michaelwong382/pokemon-deckbox-stl/example/README.md

# Expected printout

Reference renders of the remix (grey = body, blue = lid, green = pin). Compare a print against these. Views 01 to 14 were made from the second round, without the buttons, and the box has looked the same from these angles since; view 15 shows the bottom from round 3 on. The later rounds have their own renders: [stl/remix/v3/example_images/](../stl/remix/v3/example_images/) for the bottom, [stl/remix/v4/example_images/](../stl/remix/v4/example_images/) for the box with its buttons in place, and [stl/remix/v5/example_images/](../stl/remix/v5/example_images/) for the current box with the recessed pin head and the test coupons, and [stl/100_deck_ver/example_images/](../stl/100_deck_ver/example_images/) for the 100-card version.

| File | Shows |
|---|---|
| 01_closed_front_iso.png | Closed box from the front left |
| 02_closed_back_iso.png | Closed box from the back: five hinge knuckles, pin head on the left end (standing proud here; flush from round 5) |
| 03_closed_front_elevation.png | Straight-on front view: the lid seam, thumb notch under the screen, D-pad left, buttons right |
| 04_closed_side_elevation.png | Straight-on side view: the sloping side seam and the hinge sticking out 7.5 mm at the back |
| 05_open_200deg.png | Lid swung fully back, showing the inside of the lid and the open body |
| 06_open_90deg.png | Lid half open |
| 07_lid_inside_thick_frame.png | Inside of the lid: the 4 mm frame around the window, chamfered side walls, hinge knuckles |
| 08_body_front_thumb_notch.png | Body from the front: thumb notch, flat top of the front wall, side tongue strips |
| 09_catch_bead_on_body.png | Catch bead on the raised inner layer of a side wall, lid part open |
| 10_catch_groove_in_lid.png | Cutaway of the lid's side wall from inside: the groove under the chamfered inner layer |
| 11_build_plate_layout.png | All three parts in print orientation on one plate |
| 12_lid_as_printed_face_down.png | Lid on the bed, front face down |
| 13_body_as_printed_upright.png | Body on the bed, upright |
| 14_pin_as_printed_on_flat_side.png | Pin on the bed, lying on a flat side, head at one end |
| 15_bottom_signature.png | Body from below, tipped back with the front edge at the top: "Yoojin" engraved across the bottom (engraving shaded darker; the round-5 engraving, 0.8 mm deep with the small loops filled) |
