michaelwong382/pokemon-deckbox-stl/stl/remix/README.md

# Remix versions

| Folder | Round | Status |
|---|---|---|
| [v1/](v1/) | Fit for sleeved cards, five-knuckle hinge, support-free printing | Superseded |
| [v2/](v2/) | v1 plus 4 mm screen frame, snap catches, thumb notch, lead-in chamfers | Superseded; print it if you want Ashwood's signature in the bottom |
| [v3/](v3/) | v2 with "Yoojin" engraved in the bottom instead of "Ashwood" | Superseded; same box with the designer's press-fit buttons |
| [v4/](v4/) | v3 plus a D-pad and buttons redrawn to push in by hand | Superseded; same box with the 1 mm engraving and the pin head standing proud of the hinge |
| [v5/](v5/) | v4 with a shallower engraving free of tiny islands, the pin head recessed into the hinge, and three fit-test coupons | Current, print this one |

Each folder has its own README with file list, print orientation and settings. The designer's unchanged files are in [../original/](../original/); rounds 1 to 3 use the designer's D-pad and buttons.
