michaelwong382/pokemon-deckbox-stl/stl/100_deck_ver/example_images/README.md

# Example images

Renders of the 100-card version in [../](../) (grey = body, blue = lid, green = pin, coral = D-pad and buttons, sand = a 67 × 69 × 92 mm block standing in for 100 double-sleeved cards). Compare a print against these. The cameras are those of the round-5 set in [../../remix/v5/example_images/](../../remix/v5/example_images/) where the view is the same.

| File | Shows |
|---|---|
| 01_closed_front_iso.png | Closed box from the front left, buttons in place: the same front as round 5 on a box as deep as it is wide |
| 02_closed_back_iso.png | Closed box from the back: five hinge knuckles, the pin head flush in the left knuckle |
| 03_closed_side_elevation.png | Straight-on side view: the side seam runs in one straight line from the front corner to the back wall, 14° instead of 25° |
| 04_open_200deg.png | Lid swung fully back |
| 05_open_90deg_with_100_cards.png | Lid half open with the 100-card block in the body: it stands clear of the walls and 1.5 mm below the lid's ceiling line |
| 06_build_plate_layout.png | All nine pieces of the box in print orientation on one plate: body, lid, pin, D-pad, two A/B, two Start/Select |
| 07_lid_as_printed_face_down.png | Lid on the bed, front face down, 87 mm tall |
| 08_body_as_printed_upright.png | Body on the bed, upright, 78 × 80 mm footprint |
| 09_bottom_straight_on.png | The bottom straight on, front edge at the top: "Yoojin" in the middle of the 74 × 76 mm floor, the hinge knuckles along the back |
| 10_closed_from_below.png | Closed box from below its front left corner: the engraving, the front and the buttons |
| 11_next_to_the_60_card_box.png | The 100-card box beside the round-5 box, fronts aligned |
| 12_catch_bead_on_body.png | Catch bead on the raised inner wall of a side wall, lid part open: the same bead as round 5, 17 mm behind the front face, on the gentler seam |
