michaelwong382/pokemon-deckbox-stl/stl/remix/v5/example_images/README.md

# Example images

Renders of the round-5 files in [../](../) (grey = body, blue = lid, green = pin, coral = D-pad and buttons). Compare a print against these. Views 01 to 20 use the same cameras as [../../v4/example_images/](../../v4/example_images/); views 21 to 23 show the recessed pin head and the test coupons. The engraving in the bottom is shaded darker so it stands out.

| File | Shows |
|---|---|
| 01_closed_front_iso.png | Closed box from the front left, buttons in place |
| 02_closed_back_iso.png | Closed box from the back: five hinge knuckles, the pin head flush in the left knuckle |
| 03_closed_front_elevation.png | Straight-on front view: the lid seam, thumb notch under the screen, D-pad left, A/B right, Start and Select below |
| 04_closed_side_elevation.png | Straight-on side view: the sloping side seam, the hinge sticking out 7.5 mm at the back, the buttons 1.5 mm proud of the front |
| 05_open_200deg.png | Lid swung fully back, showing the inside of the lid and the open body |
| 06_open_90deg.png | Lid half open |
| 07_lid_inside_thick_frame.png | Inside of the lid: the 4 mm frame around the window, chamfered side walls, hinge knuckles |
| 08_body_front_thumb_notch.png | Body from the front: thumb notch, flat top of the front wall, side tongue strips, buttons in place |
| 09_catch_bead_on_body.png | Catch bead on the raised inner layer of a side wall, lid part open |
| 10_catch_groove_in_lid.png | Cutaway of the lid's side wall from inside: the groove under the chamfered inner layer |
| 11_build_plate_layout.png | All nine pieces of the box in print orientation on one plate: body, lid, pin, D-pad, two A/B, two Start/Select |
| 12_lid_as_printed_face_down.png | Lid on the bed, front face down |
| 13_body_as_printed_upright.png | Body on the bed, upright |
| 14_pin_as_printed_on_flat_side.png | Pin on the bed, lying on its flat side, the round head at one end |
| 15_closed_from_below.png | Closed box from below its front left corner: "Yoojin" across the bottom, buttons on the front |
| 16_bottom_straight_on.png | The bottom straight on, front edge at the top: the whole engraving, with the hinge knuckles along the back |
| 17_engraving_close_up.png | Close-up of "Yoo" from a low angle, showing the 0.8 mm depth of the strokes and the filled loops at the tops of the o's |
| 18_buttons_exploded.png | The buttons pulled 9 mm out in front of their seats: the D-pad's cross pocket, the A/B pockets with their peg holes, the Start/Select pockets |
| 19_buttons_as_printed.png | The five button pieces on the bed: D-pad and A/B face down with the four-rib pegs up, Start/Select standing with a rib on each side |
| 20_buttons_in_place.png | Close-up of the front with the buttons seated |
| 21_pin_head_recessed.png | Close-up of the left end of the hinge: the pin's round head flush in its recess in the end knuckle |
| 22_test_coupons_as_printed.png | The three coupons on the bed in print orientation, with the pin and the buttons: the seats coupon standing on its foot, the body hinge strip on its foot, the lid hinge strip on its cut face |
| 23_test_coupons_in_use.png | The seats coupon with the buttons pushed in, and the two hinge strips on the pin with the lid strip half open |
