michaelwong382/pokemon-deckbox-stl/example/01_closed_front_iso.png

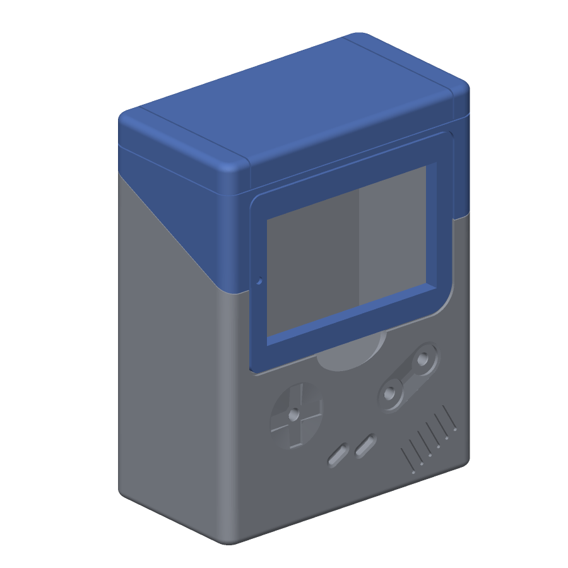
example/01_closed_front_iso.png
