michaelwong382/pokemon-deckbox-stl/example/06_open_90deg.png

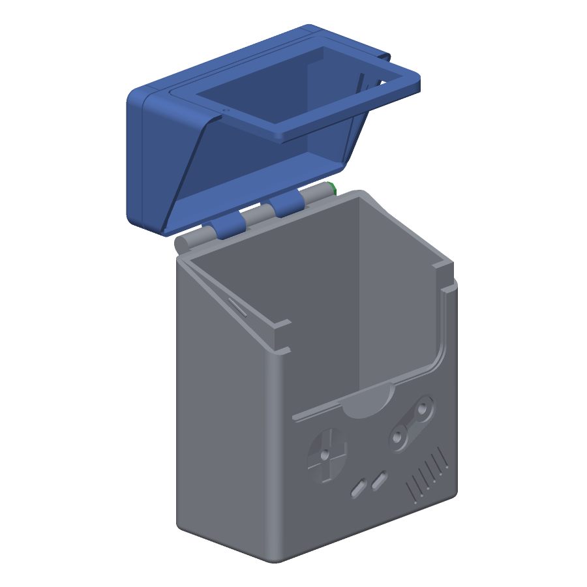
example/06_open_90deg.png
