michaelwong382/pokemon-deckbox-stl/example/07_lid_inside_thick_frame.png

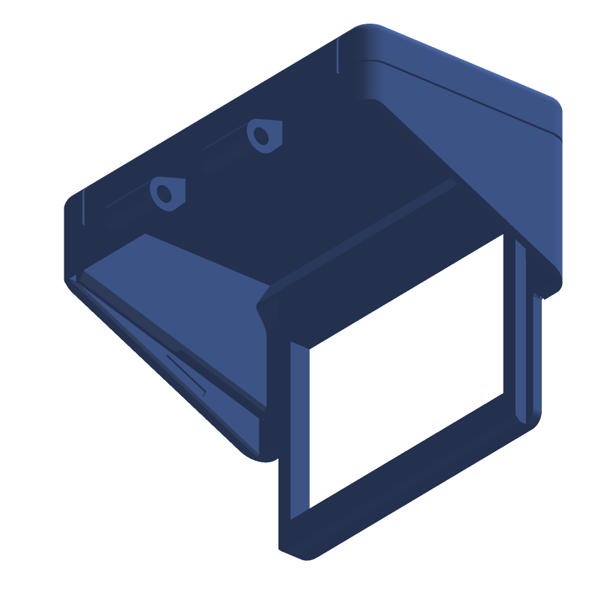
example/07_lid_inside_thick_frame.png
