michaelwong382/pokemon-deckbox-stl/example/08_body_front_thumb_notch.png

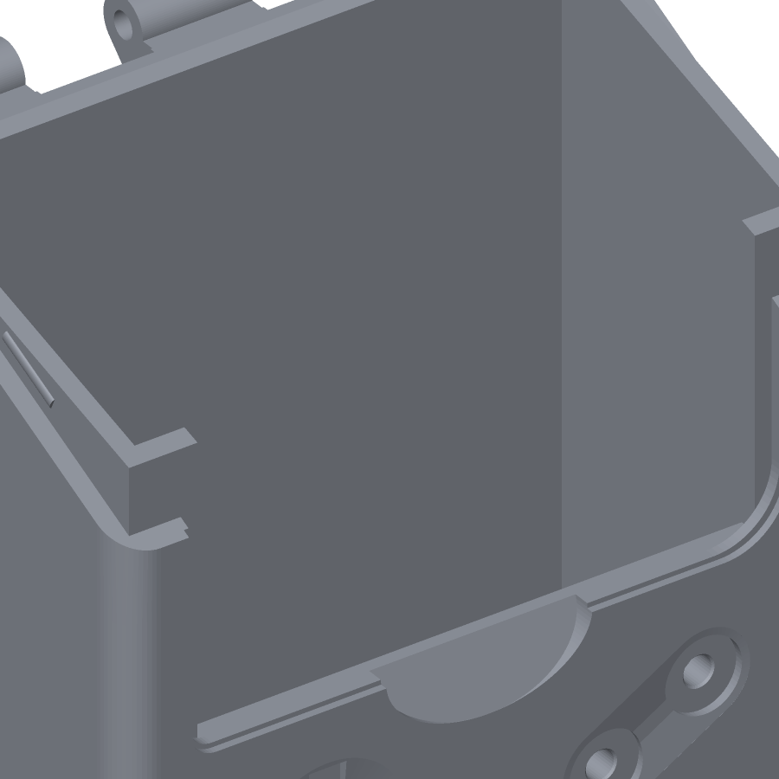
example/08_body_front_thumb_notch.png
