michaelwong382/pokemon-deckbox-stl/example/15_bottom_signature.png

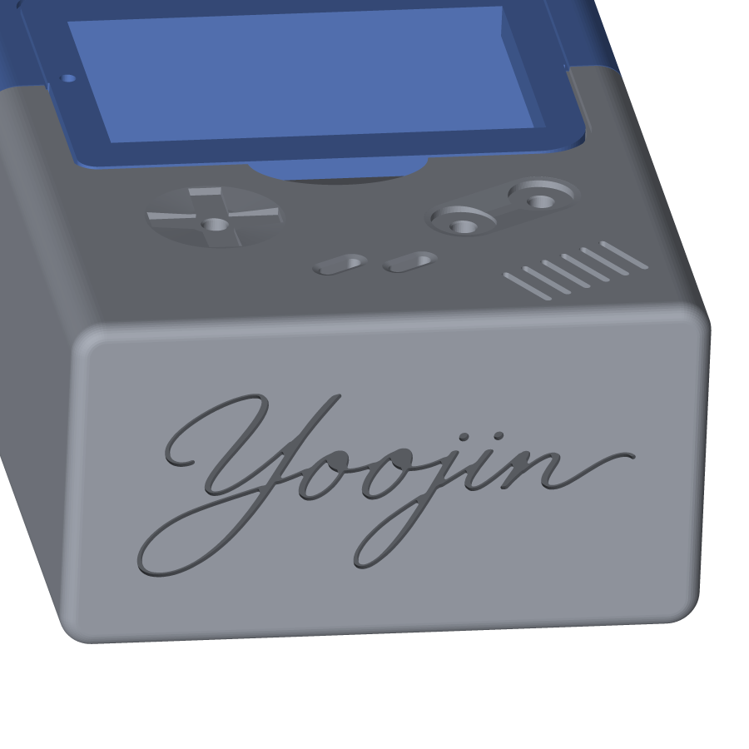
example/15_bottom_signature.png
