michaelwong382/pokemon-deckbox-stl/images/ChatGPT Image Oct 28, 2026, 07_20_07 PM.png

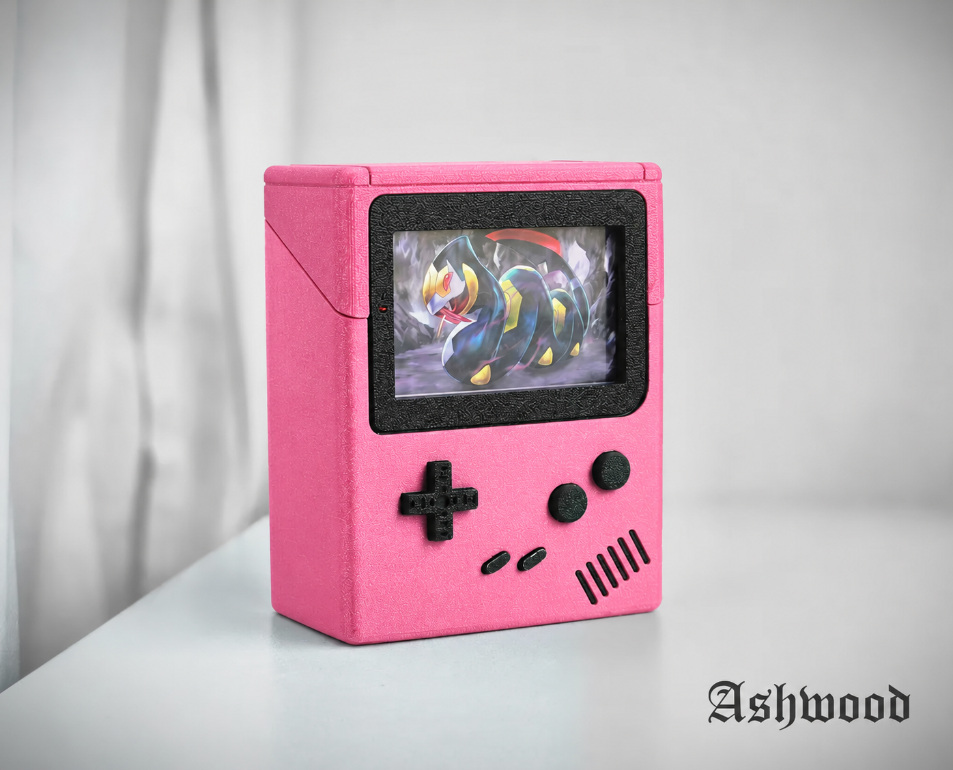
images/ChatGPT Image Oct 28, 2026, 07_20_07 PM.png
