michaelwong382/pokemon-deckbox-stl/images/Elegant_Yoojin_Calligraphy.png

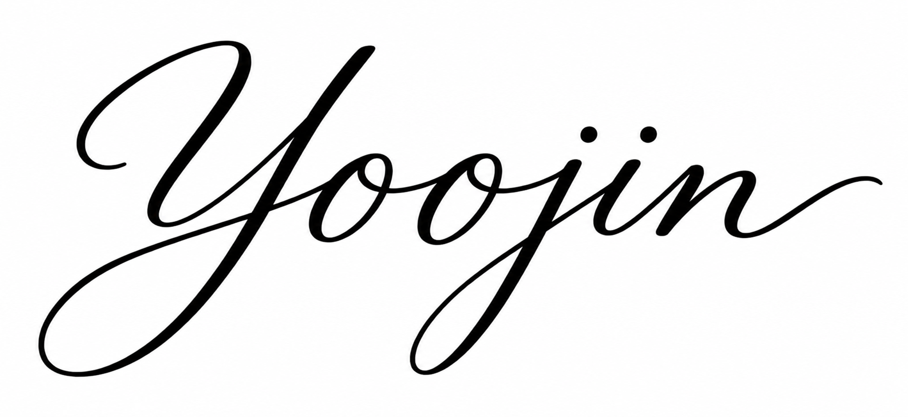
images/Elegant_Yoojin_Calligraphy.png
