michaelwong382/pokemon-deckbox-stl/images/pickachu/1-1.webp

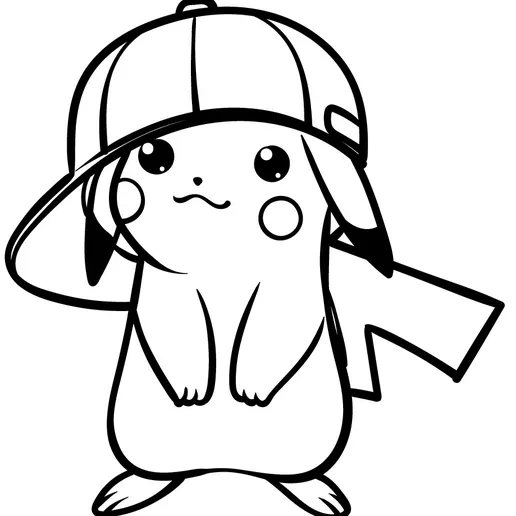
images/pickachu/1-1.webp
