michaelwong382/pokemon-deckbox-stl/images/pickachu/11_pickachu_berries_outline.png

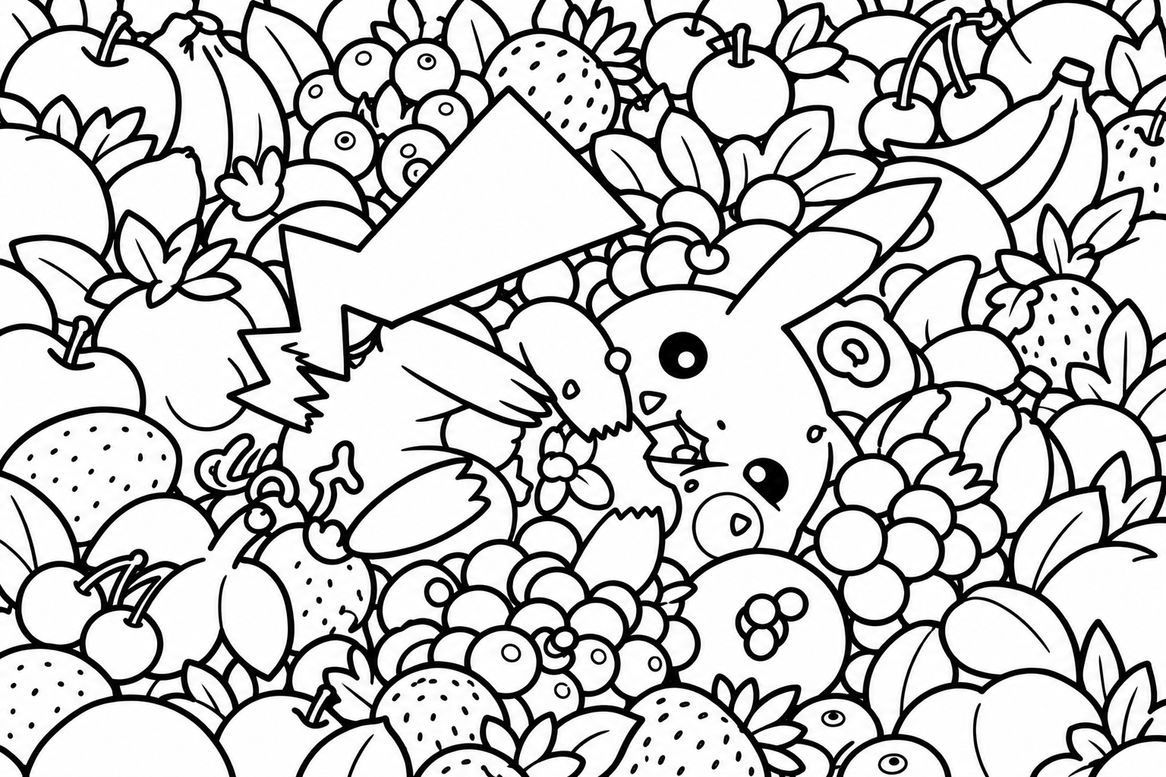
images/pickachu/11_pickachu_berries_outline.png
