michaelwong382/pokemon-deckbox-stl/images/pickachu/il_1588xN.7435648637_o518.webp

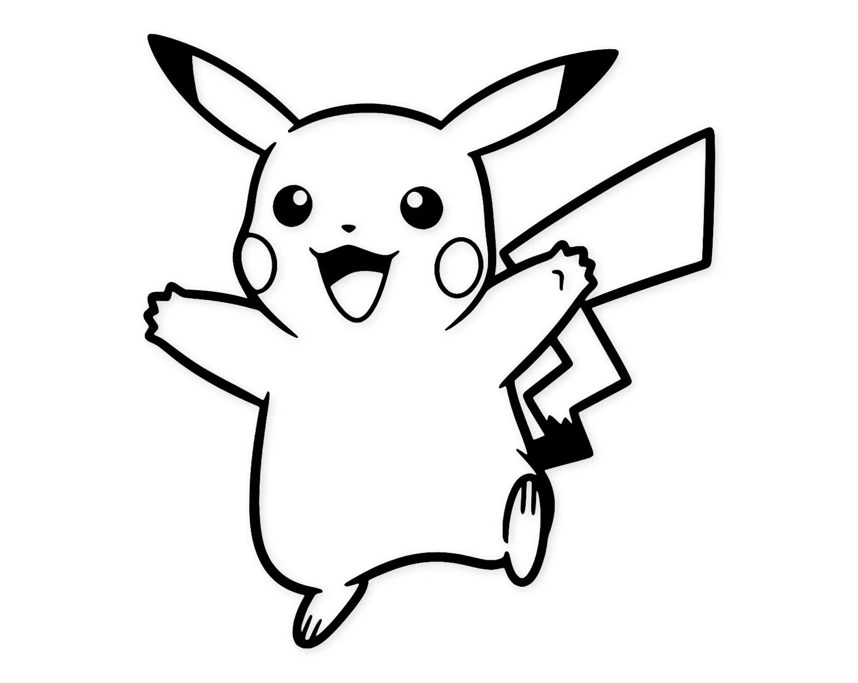
images/pickachu/il_1588xN.7435648637_o518.webp
