michaelwong382/pokemon-deckbox-stl/images/pickachu/il_1588xN.7897305927_3qdi.webp

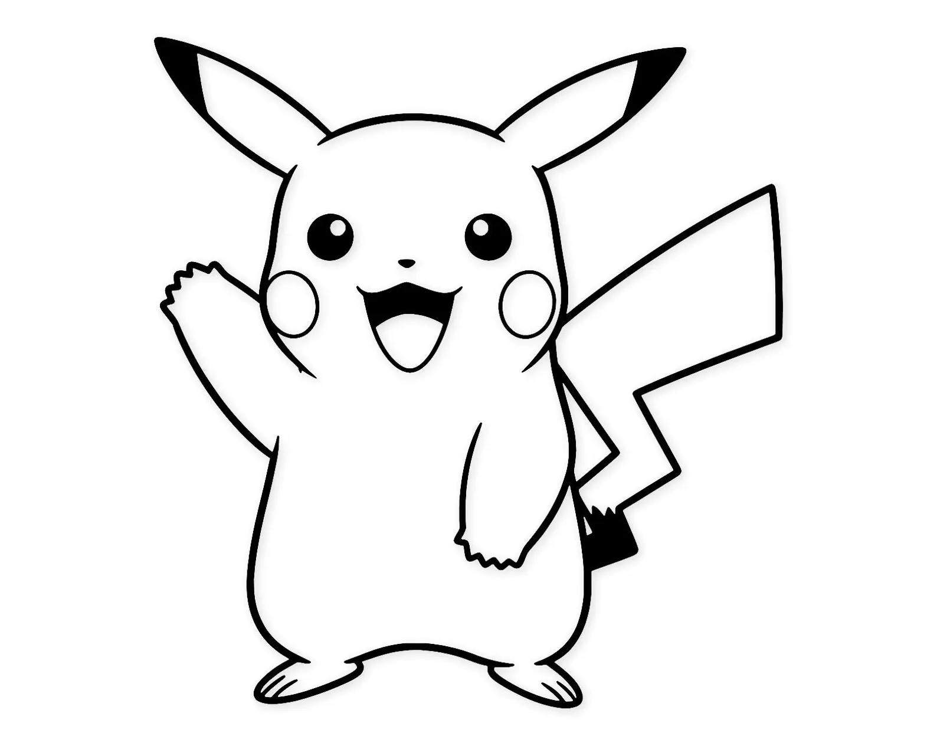
images/pickachu/il_1588xN.7897305927_3qdi.webp
