michaelwong382/pokemon-deckbox-stl/images/pickachu/il_1588xN.8249798320_c1d0.webp

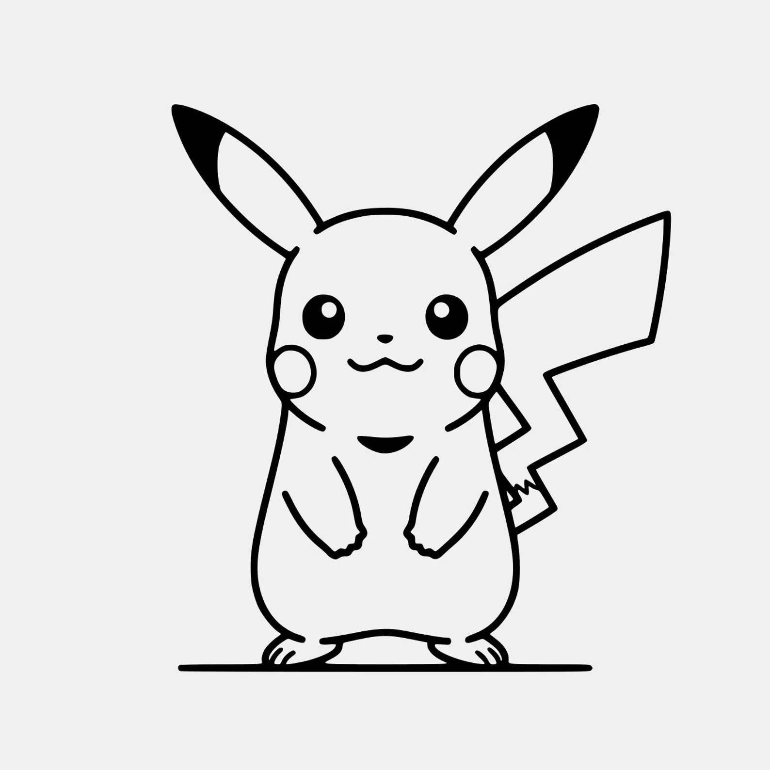
images/pickachu/il_1588xN.8249798320_c1d0.webp
