michaelwong382/pokemon-deckbox-stl/images/pickachu/il_1588xN.8268143871_6cok.webp

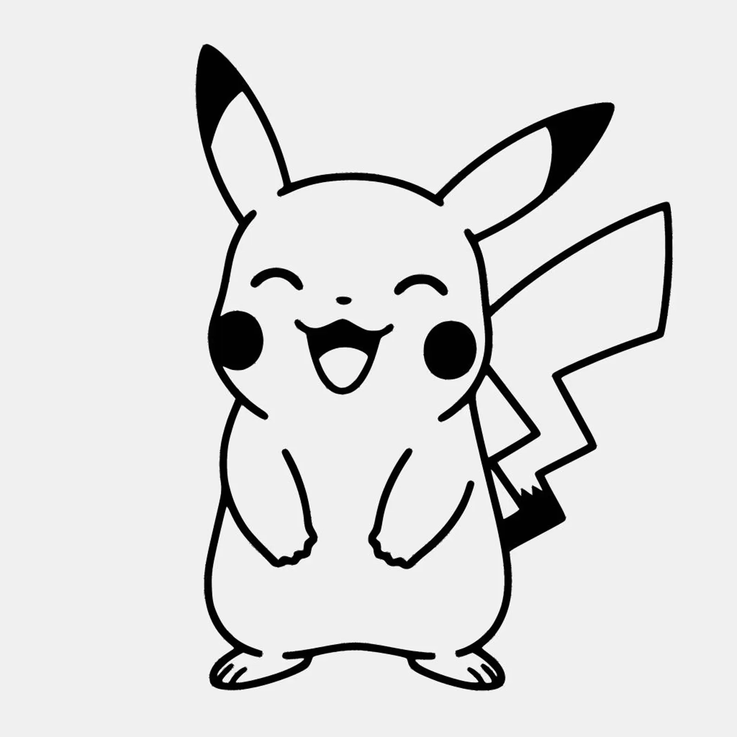
images/pickachu/il_1588xN.8268143871_6cok.webp
