michaelwong382/pokemon-deckbox-stl/images/pickachu/Pikachu-I-01-scaled.jpg

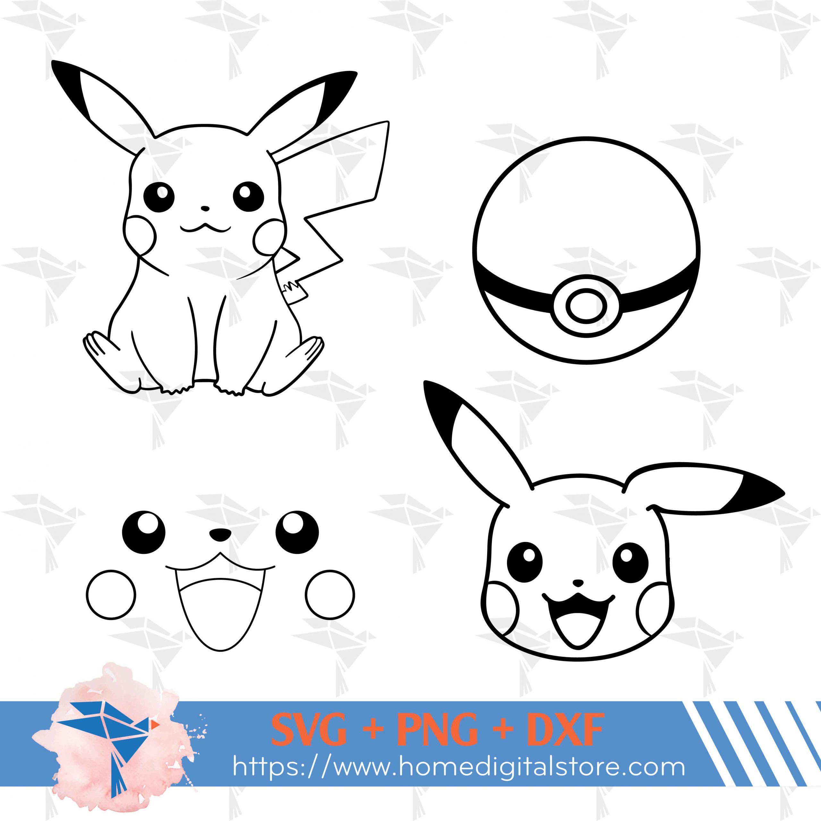
images/pickachu/Pikachu-I-01-scaled.jpg
