michaelwong382/pokemon-deckbox-stl/images/pickachu/s-l1600.jpg

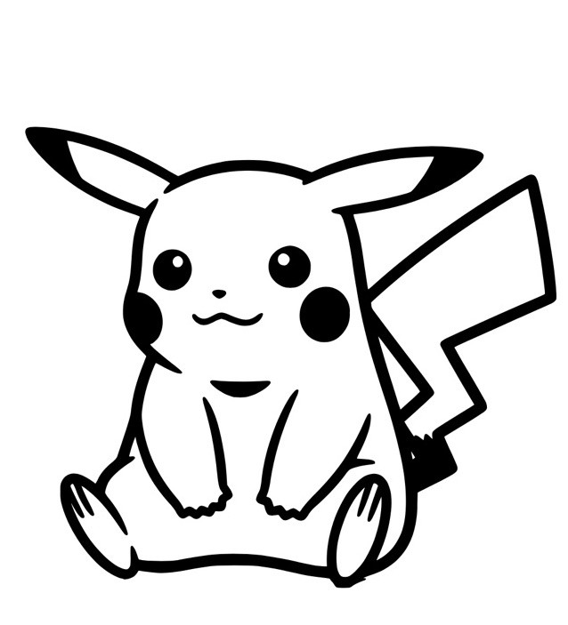
images/pickachu/s-l1600.jpg
