michaelwong382/pokemon-deckbox-stl/stl/100_deck_ver/example_images/01_closed_front_iso.png

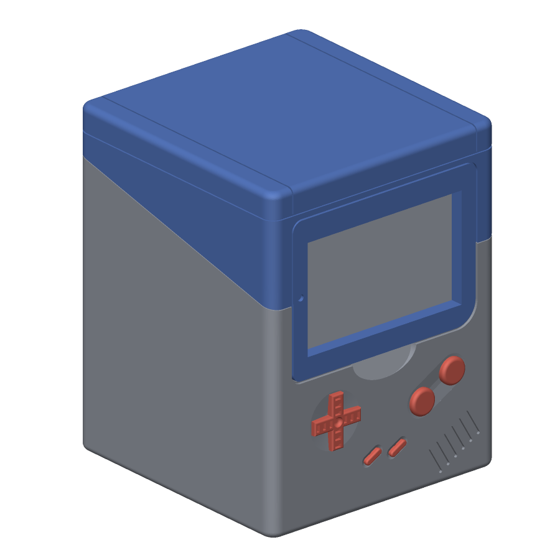
stl/100_deck_ver/example_images/01_closed_front_iso.png
