michaelwong382/pokemon-deckbox-stl/stl/100_deck_ver/example_images/02_closed_back_iso.png

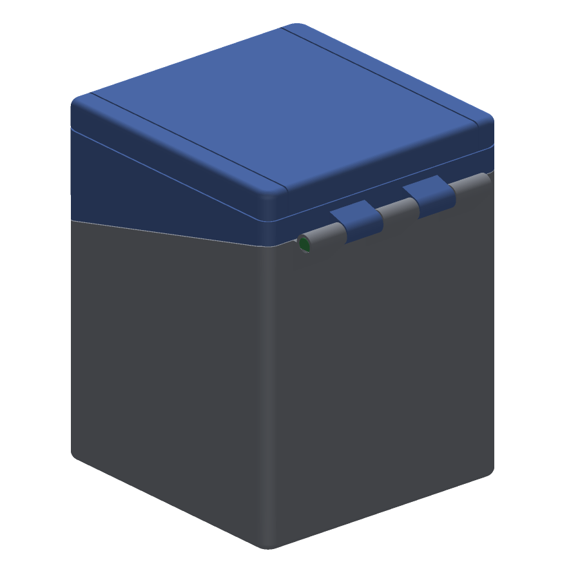
stl/100_deck_ver/example_images/02_closed_back_iso.png
