michaelwong382/pokemon-deckbox-stl/stl/100_deck_ver/example_images/03_closed_side_elevation.png

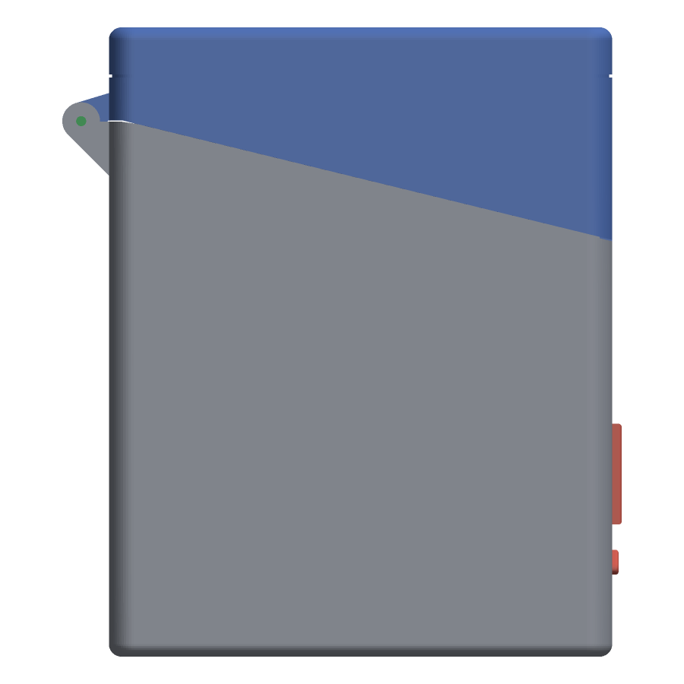
stl/100_deck_ver/example_images/03_closed_side_elevation.png
