michaelwong382/pokemon-deckbox-stl/stl/100_deck_ver/example_images/04_open_200deg.png

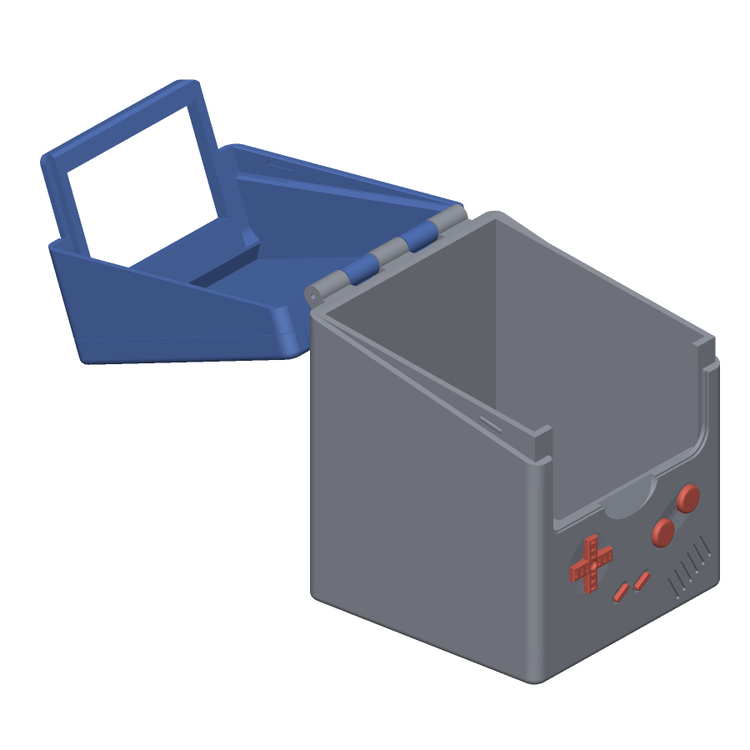
stl/100_deck_ver/example_images/04_open_200deg.png
