michaelwong382/pokemon-deckbox-stl/stl/100_deck_ver/example_images/05_open_90deg_with_100_cards.png

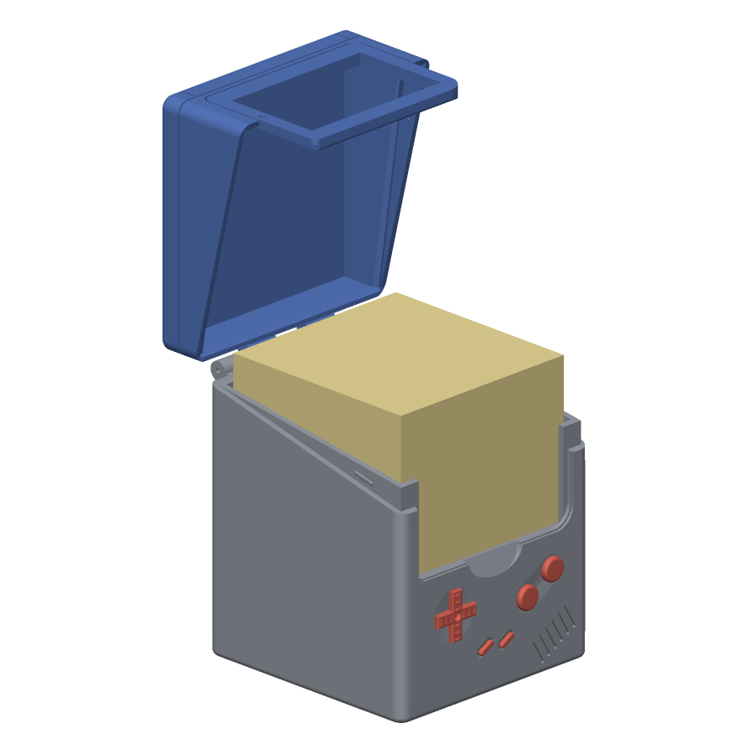
stl/100_deck_ver/example_images/05_open_90deg_with_100_cards.png
