michaelwong382/pokemon-deckbox-stl/stl/100_deck_ver/example_images/09_bottom_straight_on.png

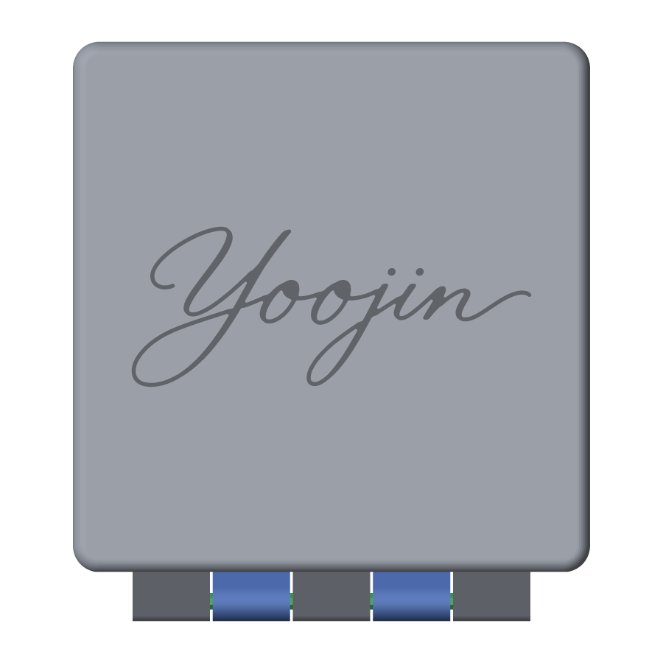
stl/100_deck_ver/example_images/09_bottom_straight_on.png
