michaelwong382/pokemon-deckbox-stl/stl/100_deck_ver/example_images/10_closed_from_below.png

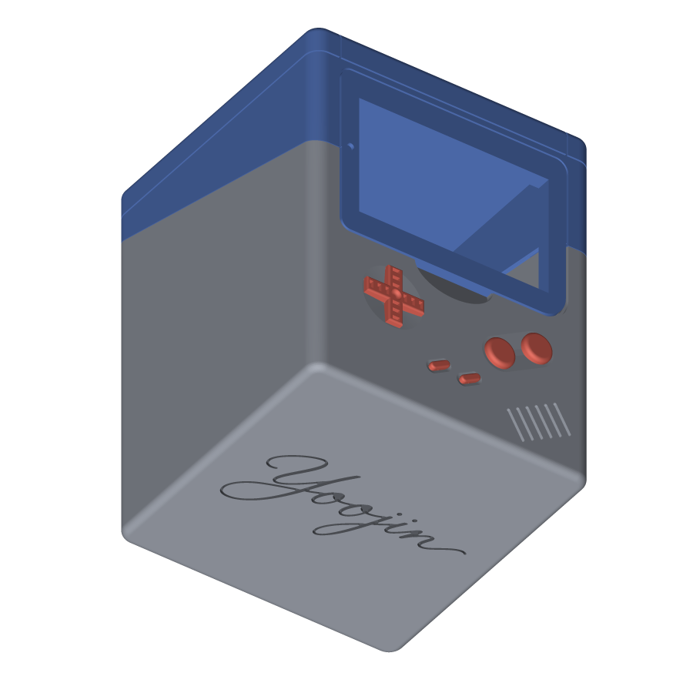
stl/100_deck_ver/example_images/10_closed_from_below.png
