michaelwong382/pokemon-deckbox-stl/stl/100_deck_ver/example_images/11_next_to_the_60_card_box.png

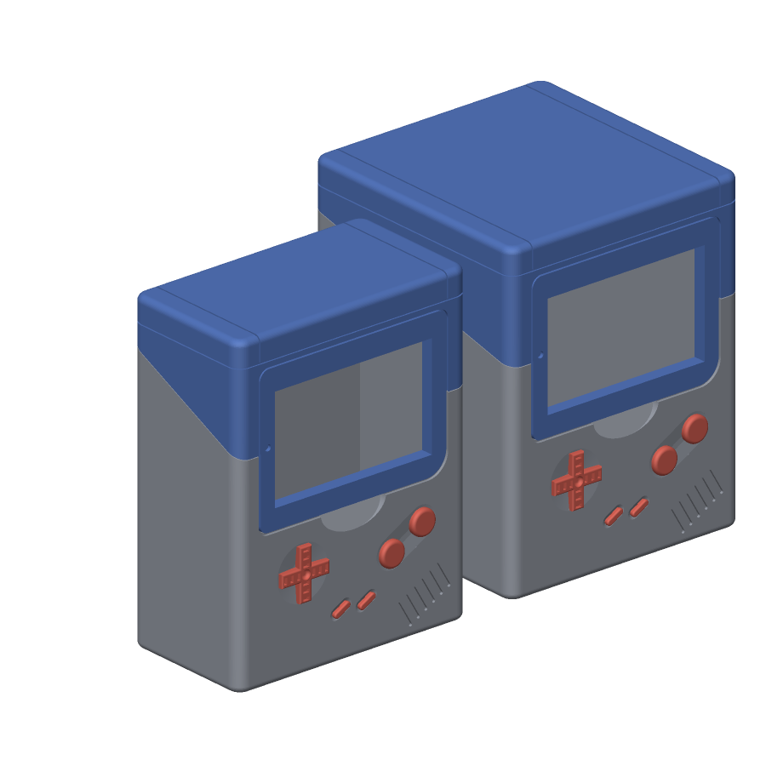
stl/100_deck_ver/example_images/11_next_to_the_60_card_box.png
