michaelwong382/pokemon-deckbox-stl/stl/100_deck_ver/example_images/12_catch_bead_on_body.png

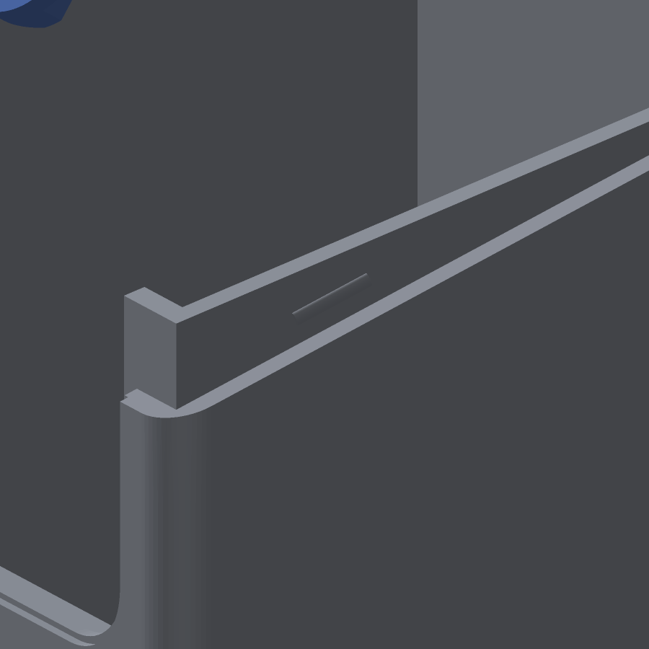
stl/100_deck_ver/example_images/12_catch_bead_on_body.png
