michaelwong382/pokemon-deckbox-stl/stl/pickachu/01_waving_back.png

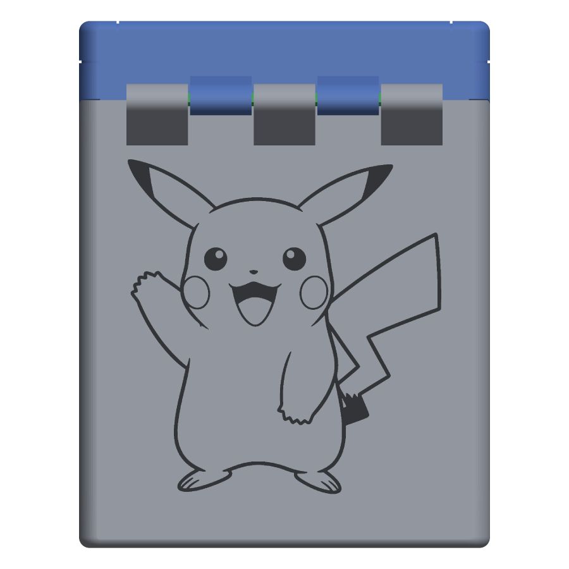
stl/pickachu/01_waving_back.png
