michaelwong382/pokemon-deckbox-stl/stl/pickachu/02_jumping_back.png

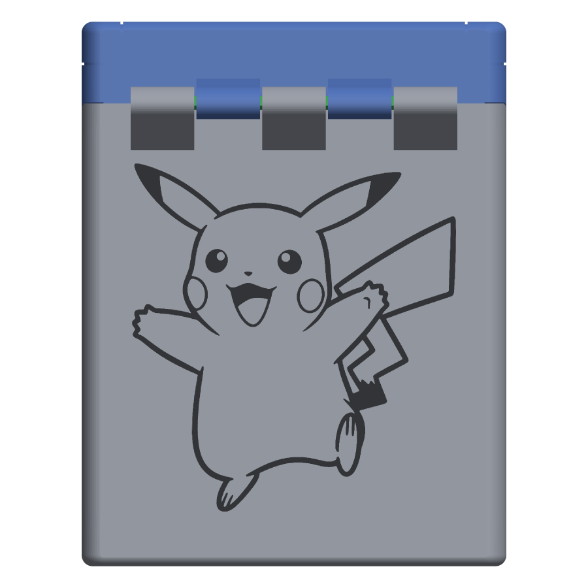
stl/pickachu/02_jumping_back.png
