michaelwong382/pokemon-deckbox-stl/stl/pickachu/04_standing_laughing_back.png

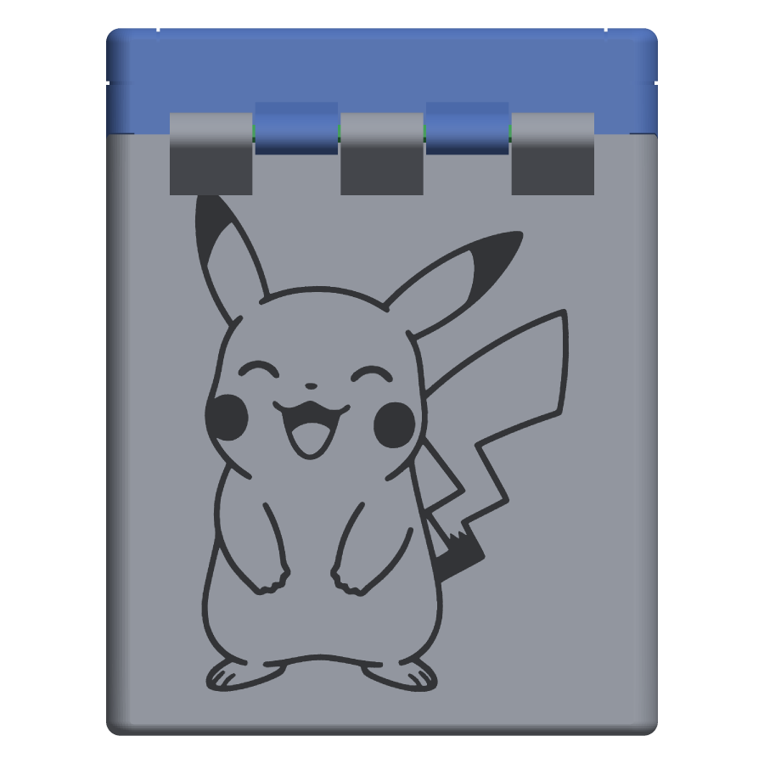
stl/pickachu/04_standing_laughing_back.png
