michaelwong382/pokemon-deckbox-stl/stl/pickachu/08_face_back_iso.png

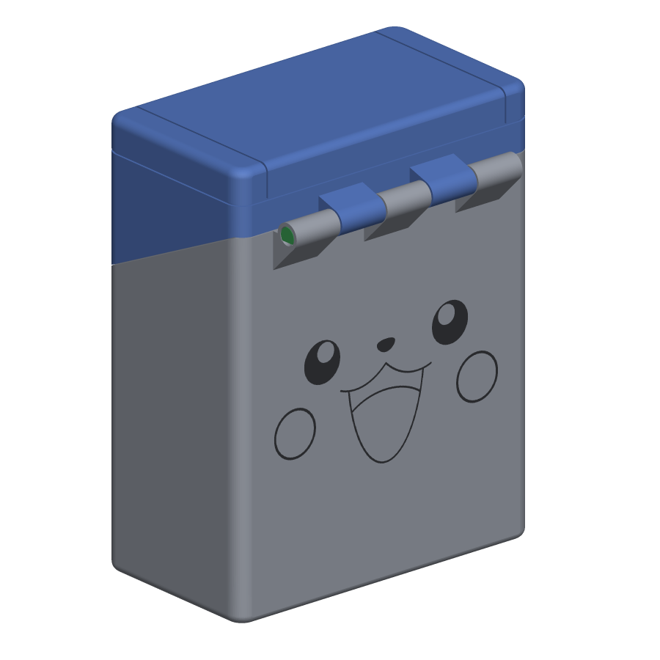
stl/pickachu/08_face_back_iso.png
