michaelwong382/pokemon-deckbox-stl/stl/pickachu/10_pokeball_back.png

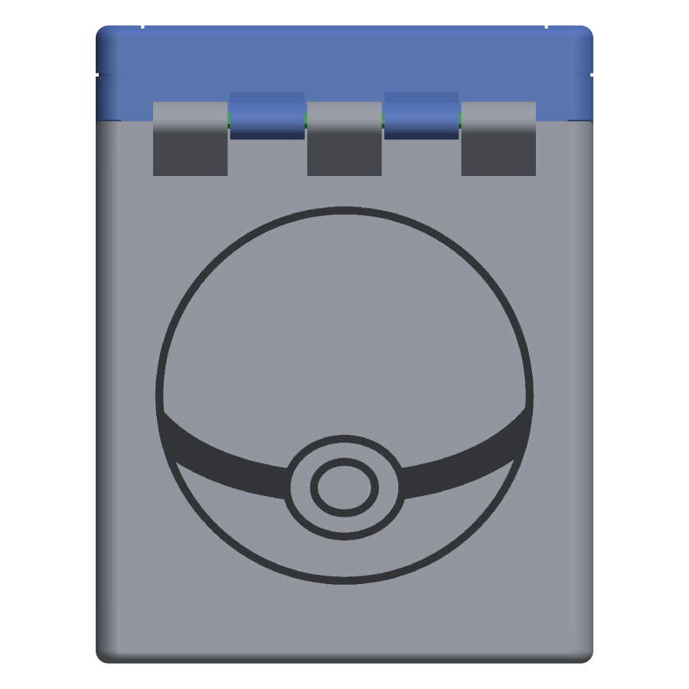
stl/pickachu/10_pokeball_back.png
