michaelwong382/pokemon-deckbox-stl/stl/pickachu/11_berries_back_iso.png

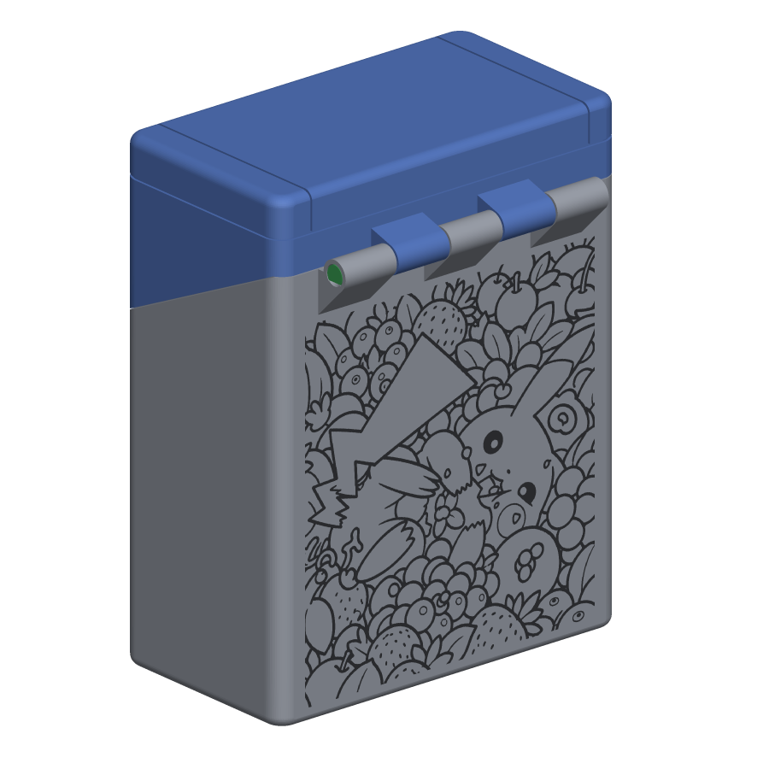
stl/pickachu/11_berries_back_iso.png
