michaelwong382/pokemon-deckbox-stl/stl/pickachu/v1_sitting_outline/example_images/04_engraving_raking_light.png

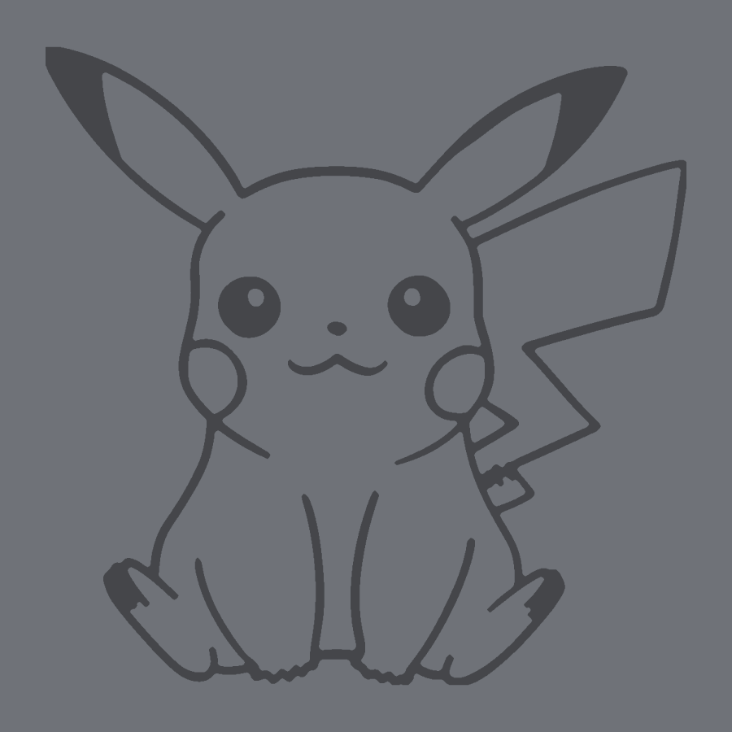
stl/pickachu/v1_sitting_outline/example_images/04_engraving_raking_light.png
