michaelwong382/pokemon-deckbox-stl/stl/pickachu/v2_berries/example_images/04_engraving_raking_light.png

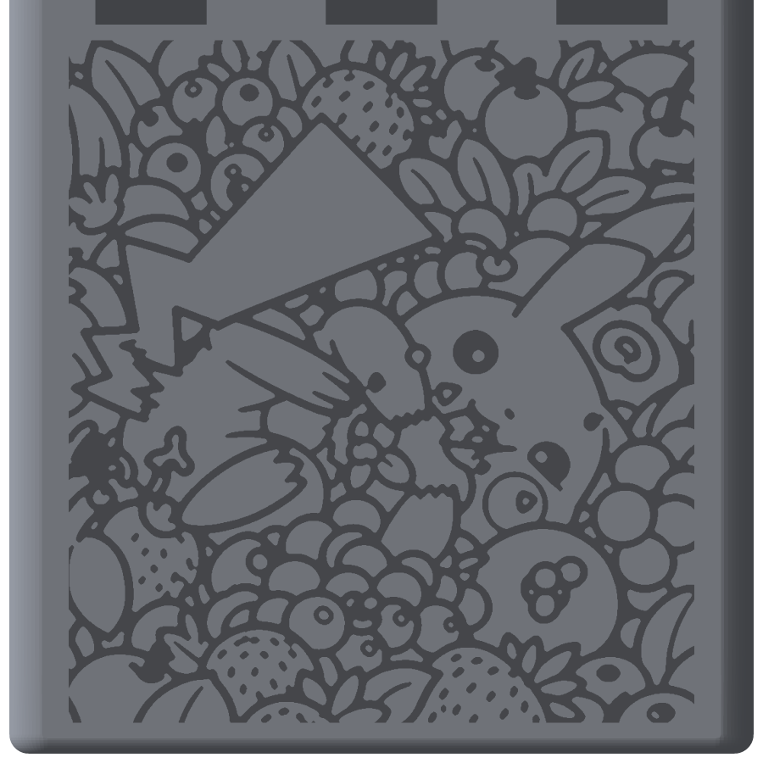
stl/pickachu/v2_berries/example_images/04_engraving_raking_light.png
