michaelwong382/pokemon-deckbox-stl/stl/pickachu/v3_berries_rotated/example_images/04_engraving_raking_light.png

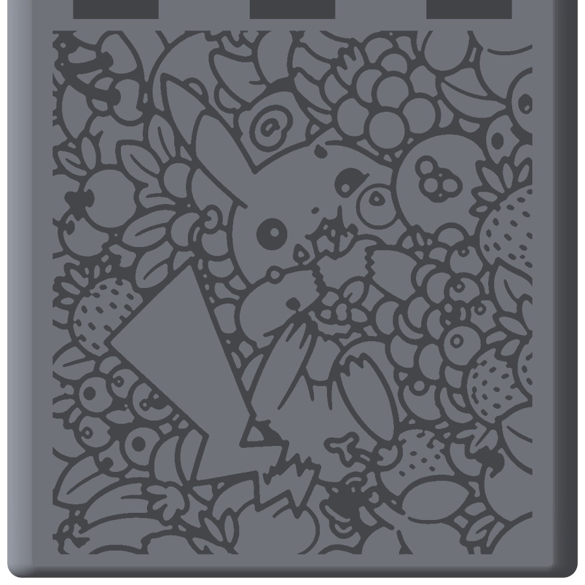
stl/pickachu/v3_berries_rotated/example_images/04_engraving_raking_light.png
