michaelwong382/pokemon-deckbox-stl/stl/pickachu/v4_berries_fade/example_images/03_engraving_close_up.png

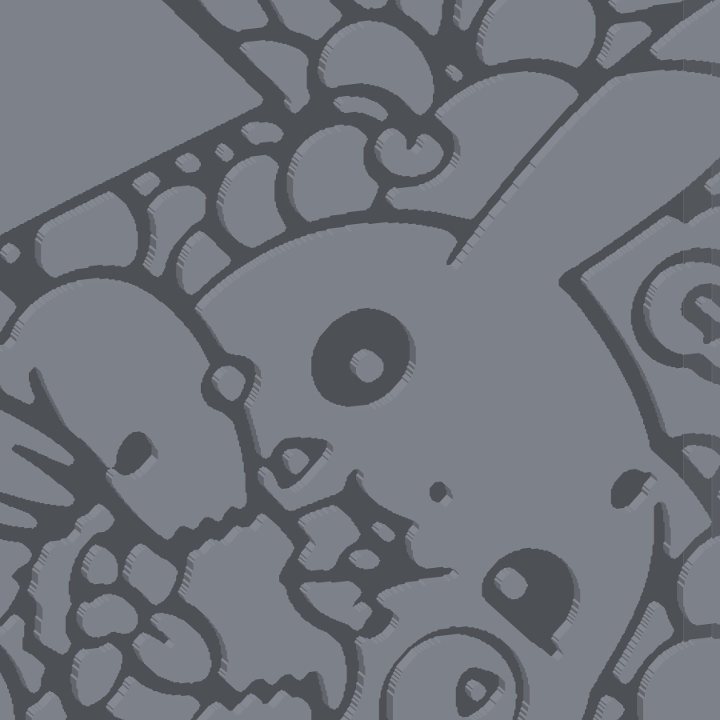
stl/pickachu/v4_berries_fade/example_images/03_engraving_close_up.png
