michaelwong382/pokemon-deckbox-stl/stl/pickachu/v4_berries_fade/example_images/04_engraving_raking_light.png

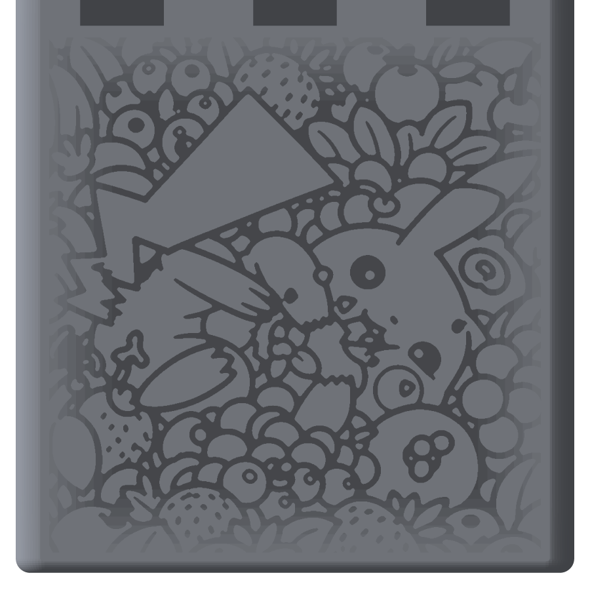
stl/pickachu/v4_berries_fade/example_images/04_engraving_raking_light.png
