michaelwong382/pokemon-deckbox-stl/stl/remix/v5/example_images/02_closed_back_iso.png

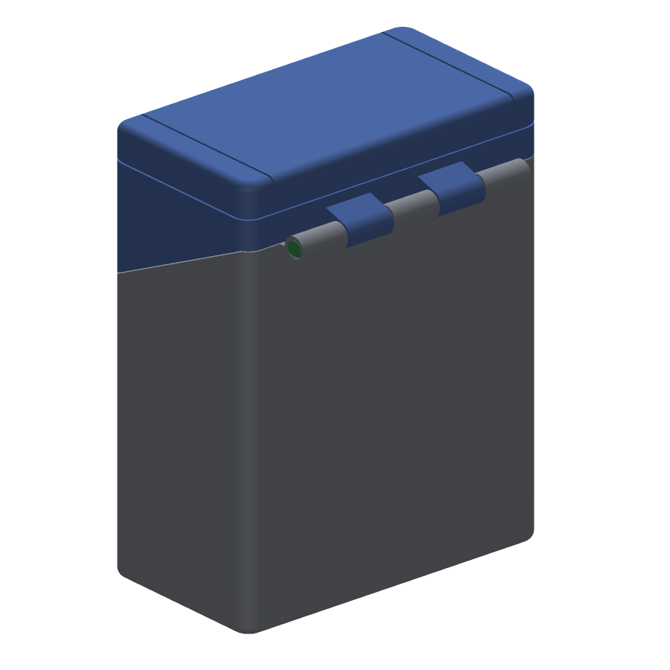
stl/remix/v5/example_images/02_closed_back_iso.png
