michaelwong382/pokemon-deckbox-stl/stl/remix/v5/example_images/04_closed_side_elevation.png

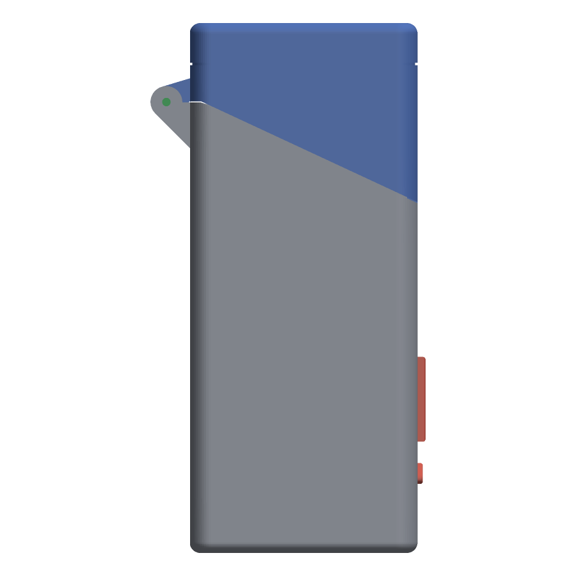
stl/remix/v5/example_images/04_closed_side_elevation.png
