michaelwong382/pokemon-deckbox-stl/stl/remix/v5/example_images/09_catch_bead_on_body.png

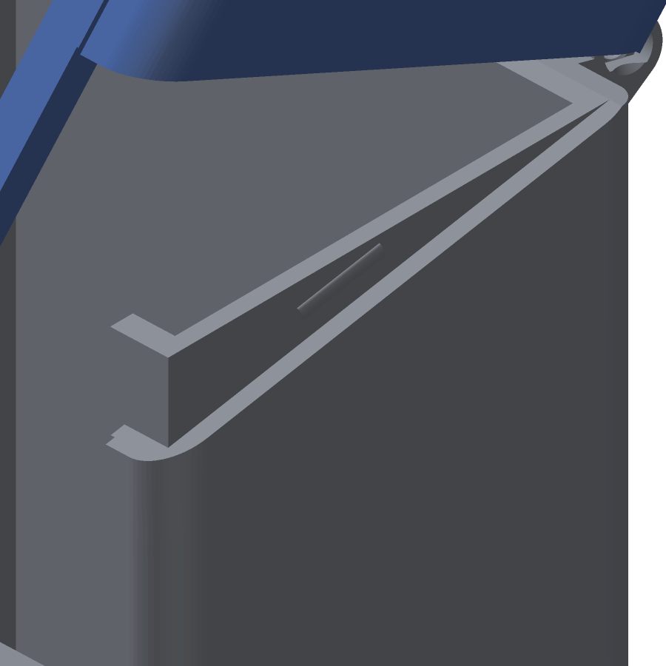
stl/remix/v5/example_images/09_catch_bead_on_body.png
