michaelwong382/pokemon-deckbox-stl/stl/remix/v5/example_images/15_closed_from_below.png

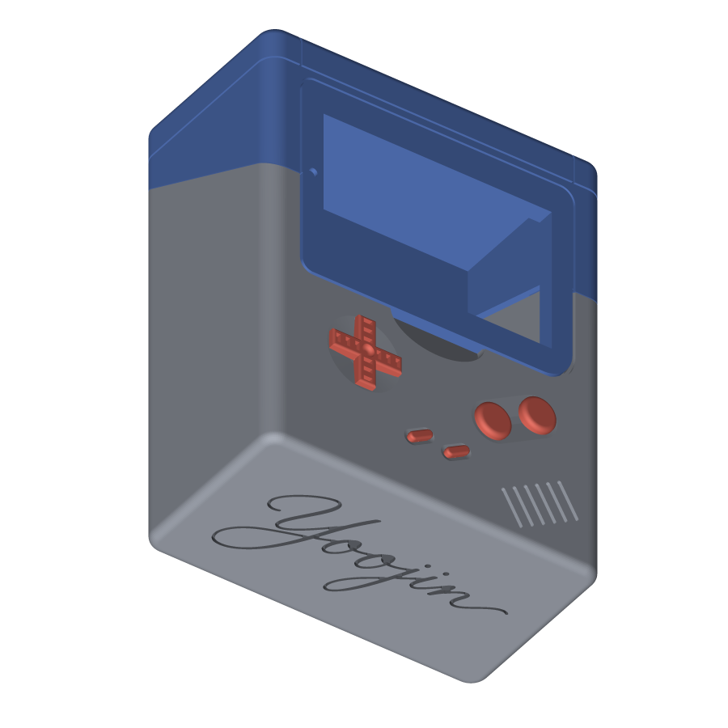
stl/remix/v5/example_images/15_closed_from_below.png
