michaelwong382/pokemon-deckbox-stl/stl/remix/v5/example_images/16_bottom_straight_on.png

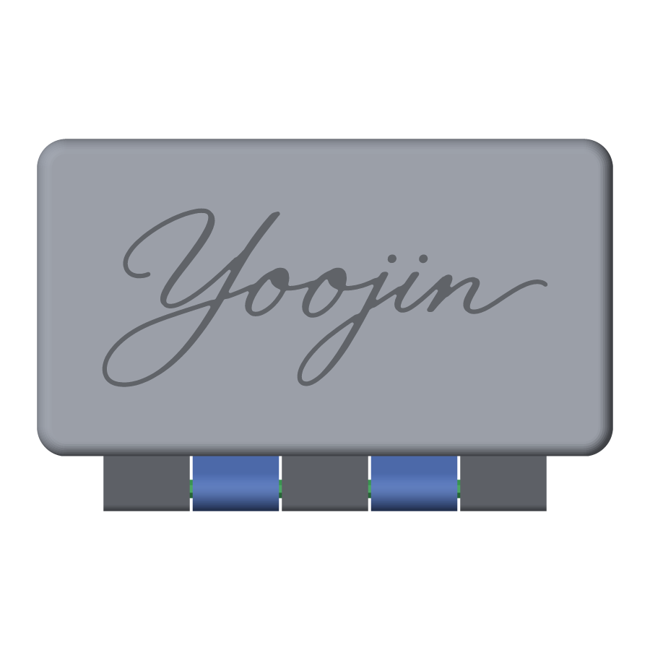
stl/remix/v5/example_images/16_bottom_straight_on.png
