michaelwong382/pokemon-deckbox-stl/stl/remix/v5/example_images/20_buttons_in_place.png

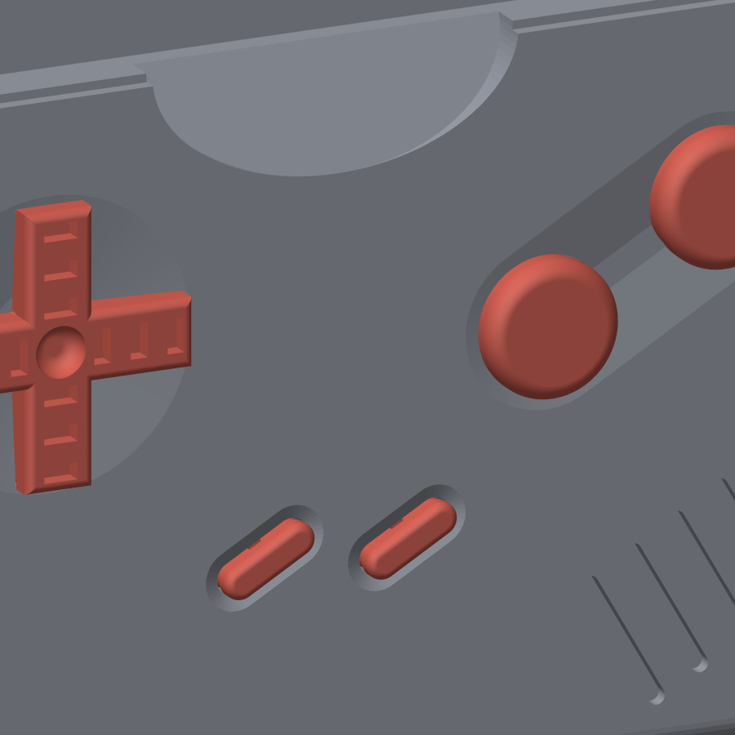
stl/remix/v5/example_images/20_buttons_in_place.png
