michaelwong382/pokemon-deckbox-stl/stl/remix/v5/example_images/21_pin_head_recessed.png

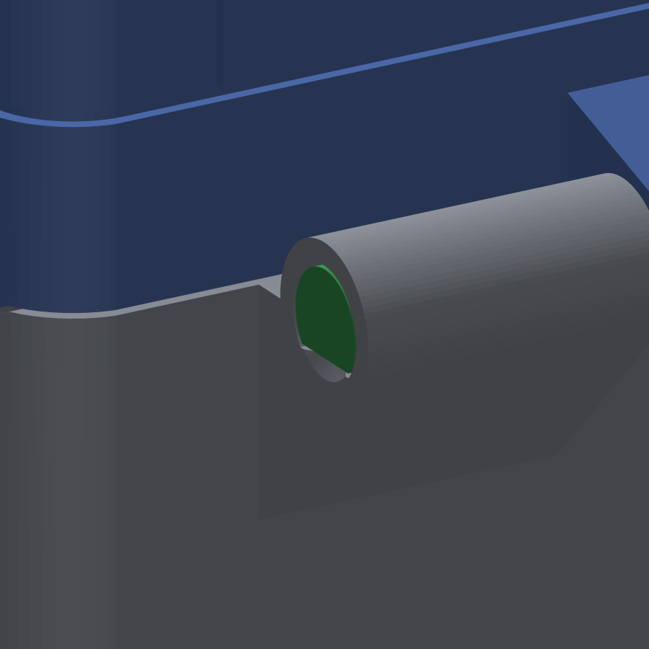
stl/remix/v5/example_images/21_pin_head_recessed.png
