michaelwong382/pokemon-deckbox-stl/stl/original/Case-bottom.stl

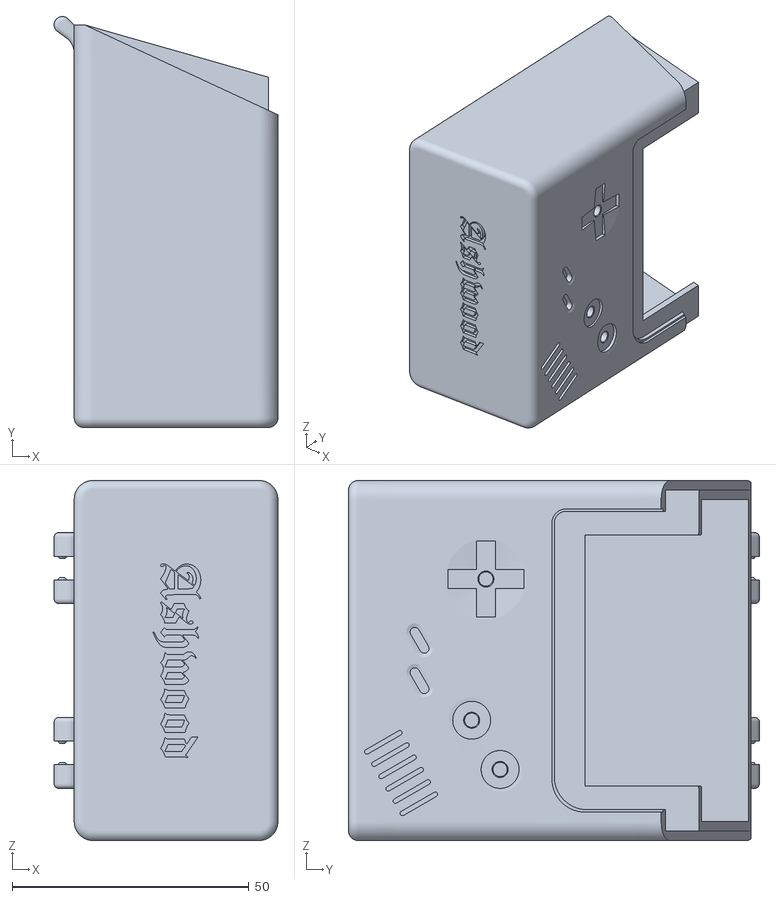
[picture p85: CAD file, 2026-10-29]
stl/original/Case-bottom.stl
47.2 x 86.7 x 76.0
