michaelwong382/pokemon-deckbox-stl/stl/pickachu/v2_berries/StartSelect_remix.stl

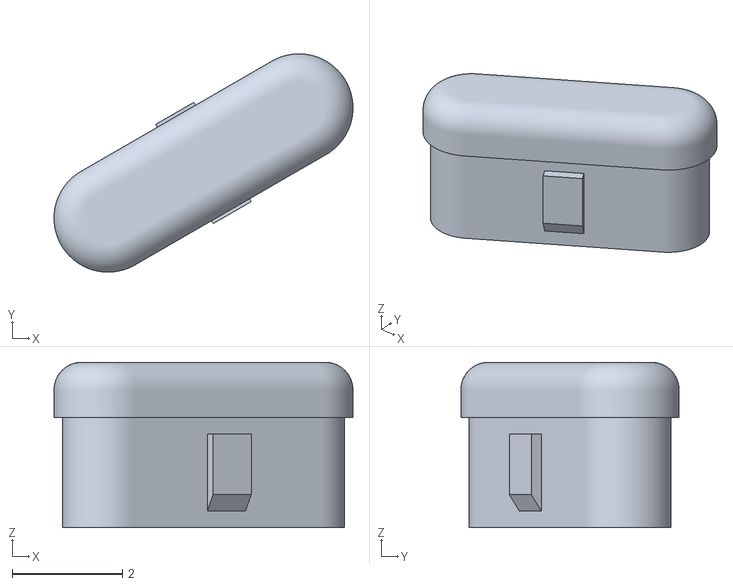
[picture p87: CAD file, 2026-10-31]
stl/pickachu/v2_berries/StartSelect_remix.stl
5.42 x 3.96 x 3.00
