michaelwong382/pokemon-deckbox-stl/stl/pickachu/v3_berries_rotated/Case-bottom_remix.stl

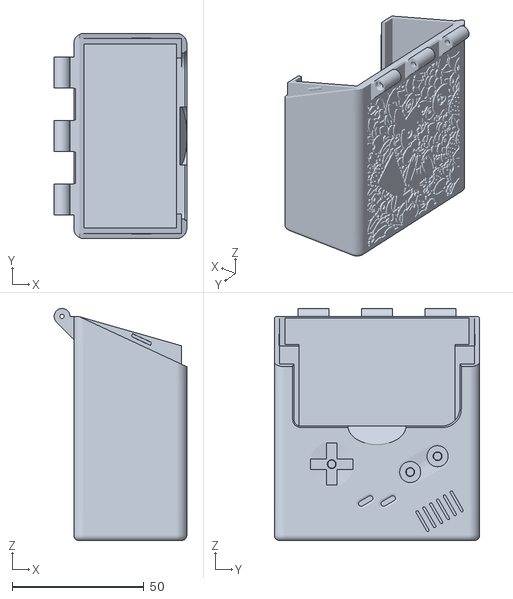
[picture p88: CAD file, 2026-10-31]
stl/pickachu/v3_berries_rotated/Case-bottom_remix.stl
50.4 x 78.0 x 88.1
