michaelwong382/pokemon-deckbox-stl/stl/pickachu/v7_berries_pruned_pokeball_top/Test-hinge-lid.stl

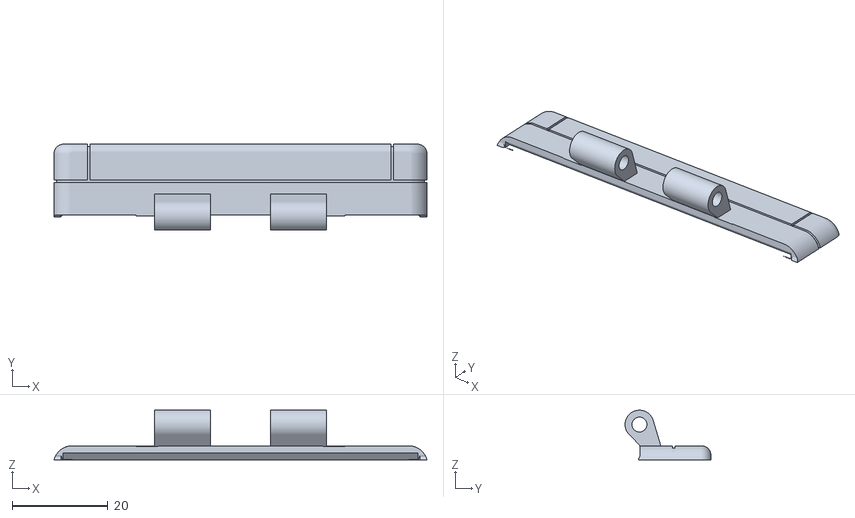
[picture p90: CAD file, 2026-10-31]
stl/pickachu/v7_berries_pruned_pokeball_top/Test-hinge-lid.stl
77.7 x 17.9 x 10.4
