michaelwong382/pokemon-deckbox-stl/stl/remix/v5/Button_remix.stl

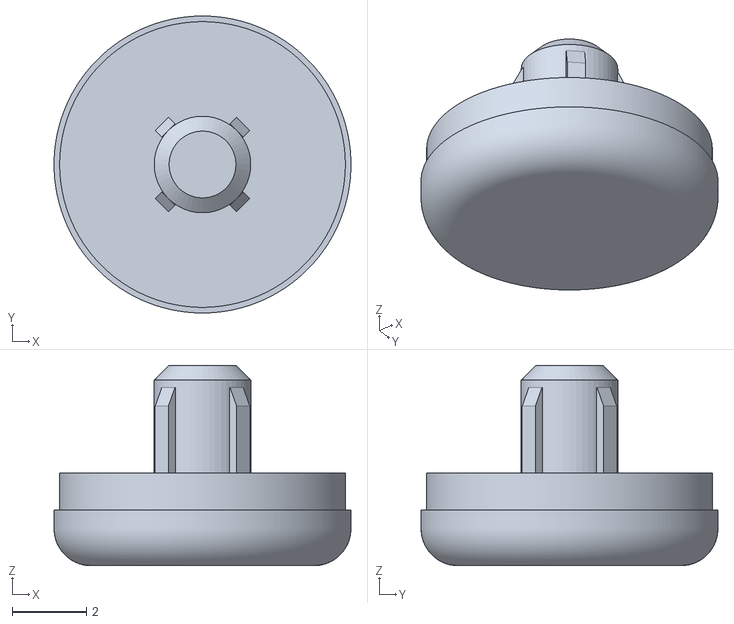
[picture p91: CAD file, 2026-10-29]
stl/remix/v5/Button_remix.stl
8.00 x 8.00 x 5.40
