michaelwong382/pokemon-deckbox-stl/stl/pickachu/v1_sitting_outline/Case-top_remix.stl

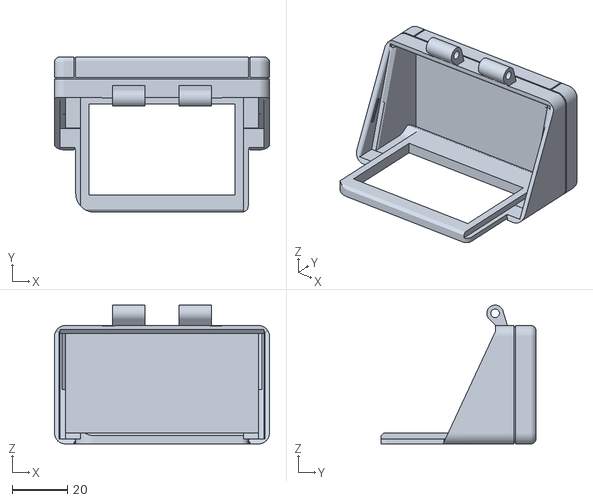
[picture p92: CAD file, 2026-10-31]
stl/pickachu/v1_sitting_outline/Case-top_remix.stl
78.0 x 56.4 x 50.4
