michaelwong382/pokemon-deckbox-stl/stl/pickachu/v5_berries_dropout/Test-seats.stl

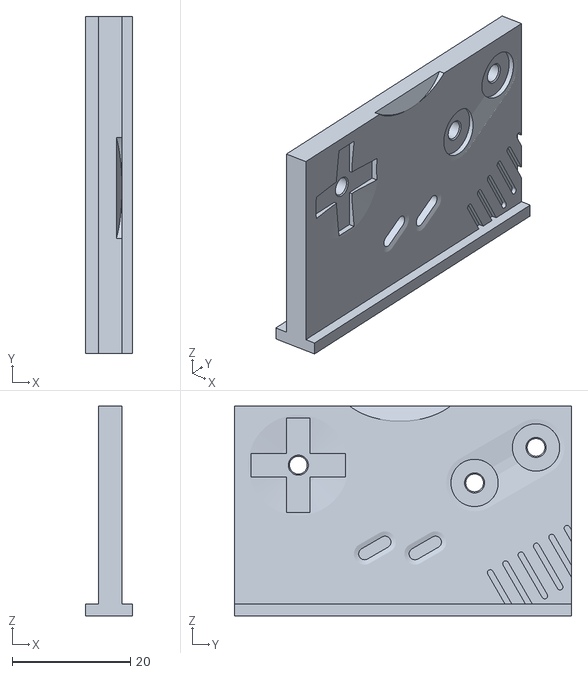
[picture p93: CAD file, 2026-10-31]
stl/pickachu/v5_berries_dropout/Test-seats.stl
8.00 x 57.0 x 35.5
