michaelwong382/pokemon-deckbox-stl/stl/original/Case-top.stl

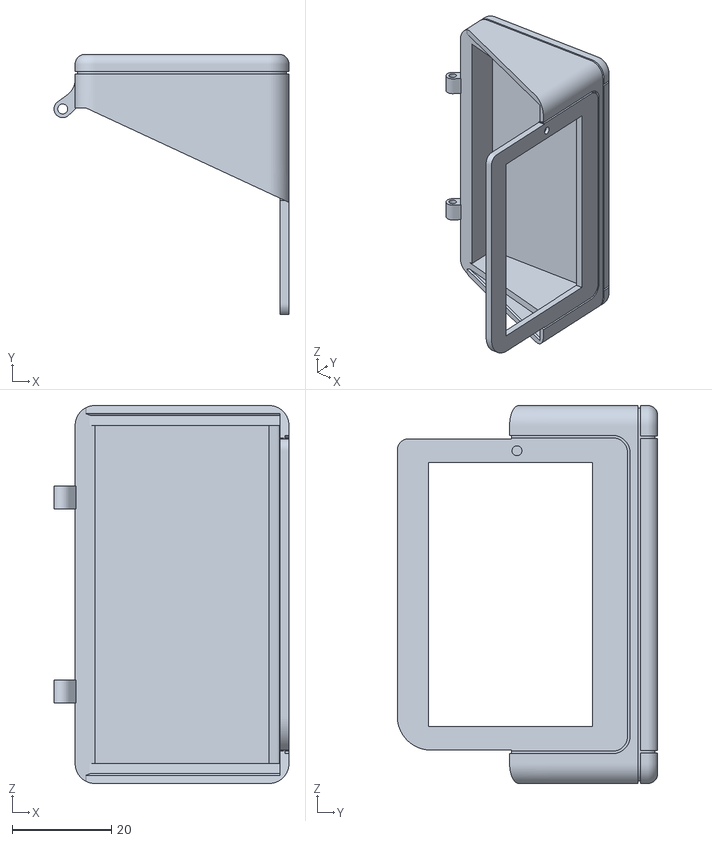
[picture p94: CAD file, 2026-10-29]
stl/original/Case-top.stl
47.2 x 52.4 x 76.0
