michaelwong382/pokemon-deckbox-stl/stl/pickachu/v1_sitting_outline/D-Pad_remix.stl

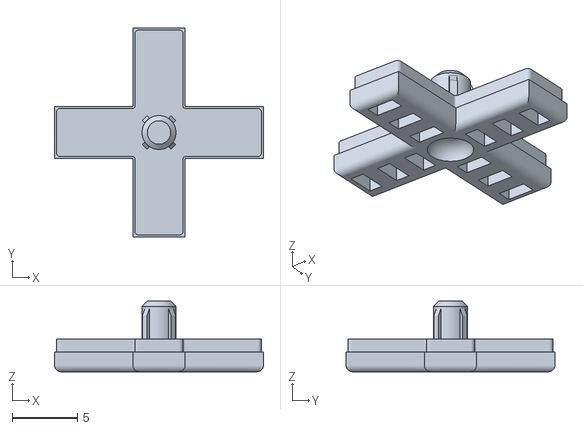
[picture p95: CAD file, 2026-10-31]
stl/pickachu/v1_sitting_outline/D-Pad_remix.stl
16.0 x 16.0 x 5.40
