michaelwong382/pokemon-deckbox-stl/stl/pickachu/v5_berries_dropout/Hinge-pin_remix.stl

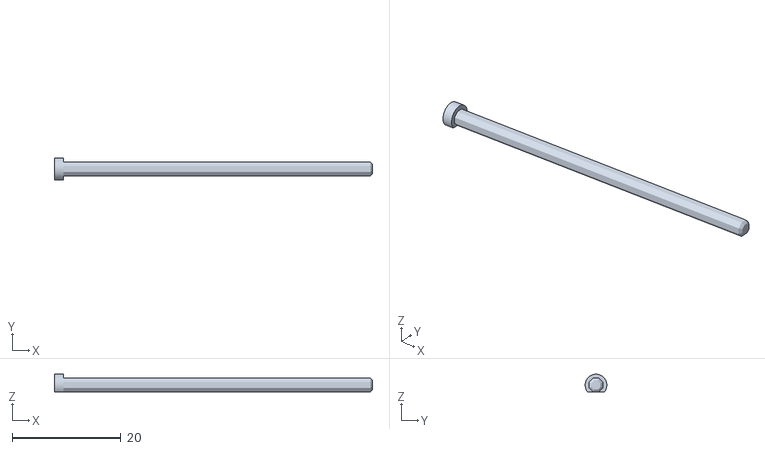
[picture p96: CAD file, 2026-10-31]
stl/pickachu/v5_berries_dropout/Hinge-pin_remix.stl
58.5 x 4.00 x 3.25
