michaelwong382/pokemon-deckbox-stl/stl/original/Case-GB.3mf

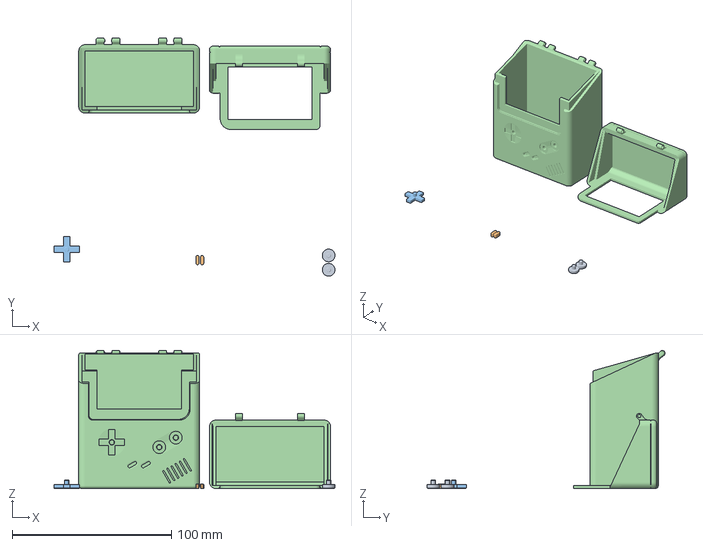
[picture p97: CAD file, 2026-10-29]
stl/original/Case-GB.3mf
176.5 x 149.7 x 86.7 mm
Montage x 3
D-Pad.stl
