michaelwong382/pokemon-deckbox-stl/stl/pickachu/v7_berries_pruned_pokeball_top/Test-hinge-body.stl

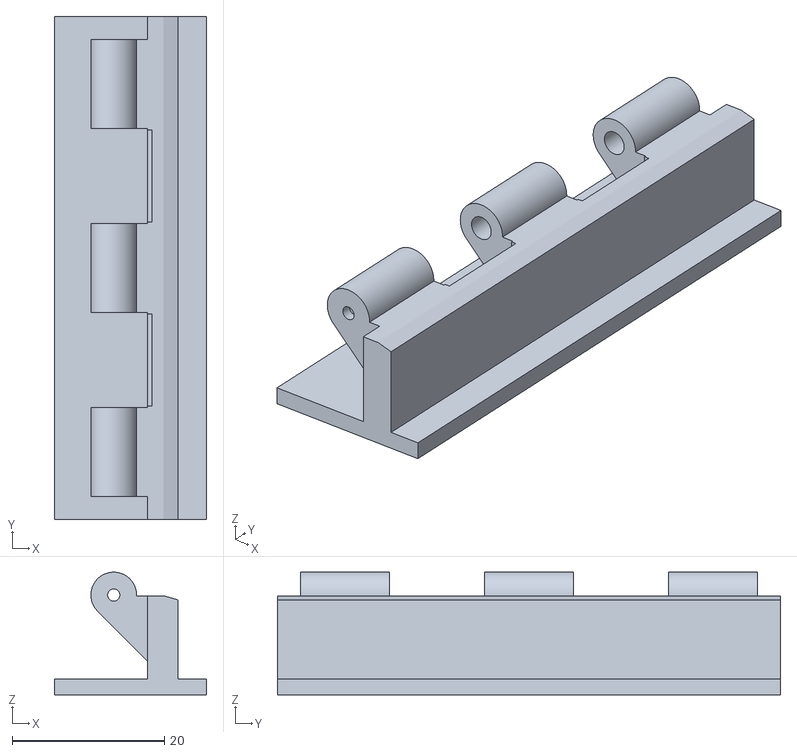
[picture p98: CAD file, 2026-10-31]
stl/pickachu/v7_berries_pruned_pokeball_top/Test-hinge-body.stl
20.0 x 66.0 x 16.1
