michaelwong382/pokemon-deckbox-stl/(list of files, cad)

Other CAD files:
stl/pickachu/v5_berries_dropout/Case-bottom_remix.stl
stl/original/Button.stl
stl/pickachu/v2_berries/Case-bottom_remix.stl
stl/pickachu/v7_berries_pruned_pokeball_top/Case-top_remix.stl
stl/remix/v5/Case-bottom_remix.stl
stl/pickachu/v7_berries_pruned_pokeball_top/Case-bottom_remix.stl
stl/original/D-Pad.stl
stl/original/StartSelect.stl
stl/100_deck_ver/Case-bottom_remix.stl
stl/100_deck_ver/Case-top_remix.stl
stl/remix/v1/Case-bottom_remix.stl
stl/remix/v1/Case-top_remix.stl
stl/remix/v2/Case-bottom_remix.stl
stl/remix/v3/Case-bottom_remix.stl
stl/remix/v4/Hinge-pin_remix.stl
