michaelwong382/pokemon-deckbox-stl/example/11_build_plate_layout.png

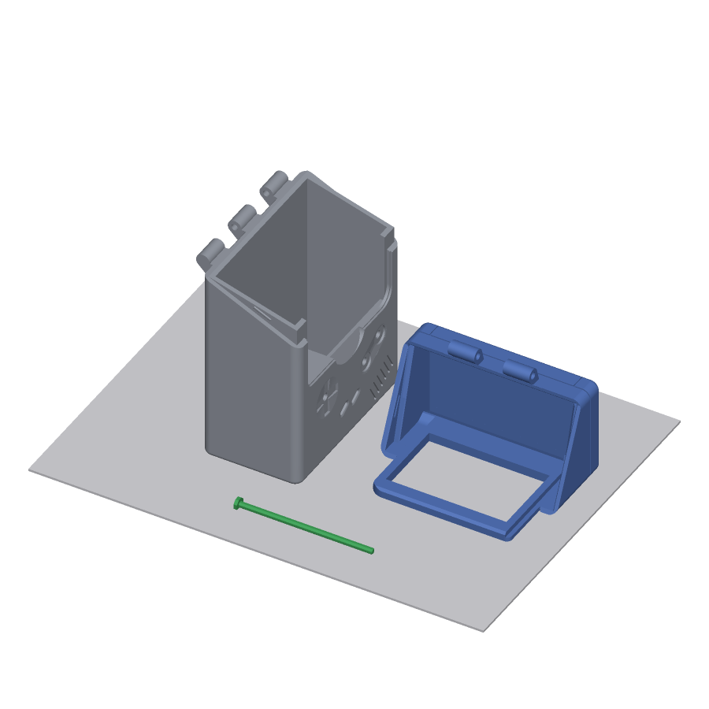
example/11_build_plate_layout.png
