michaelwong382/pokemon-deckbox-stl/example/13_body_as_printed_upright.png

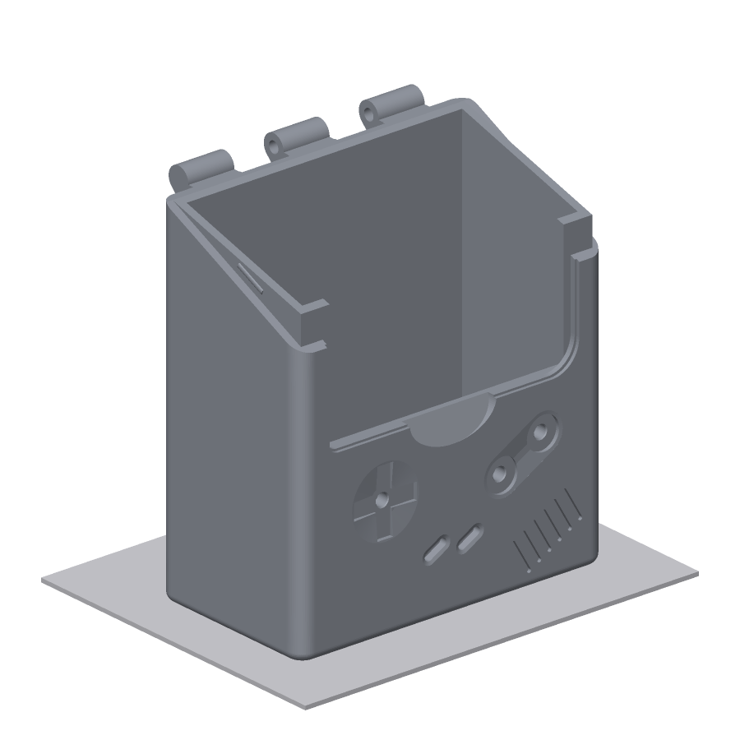
example/13_body_as_printed_upright.png
