michaelwong382/pokemon-deckbox-stl/example/14_pin_as_printed_on_flat_side.png

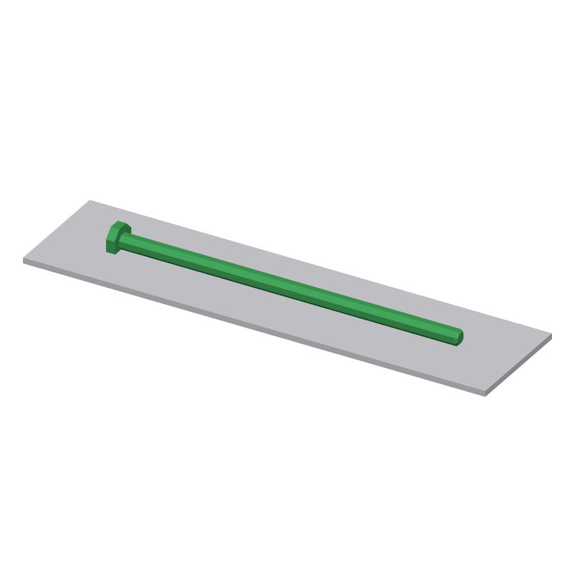
example/14_pin_as_printed_on_flat_side.png
