michaelwong382/pokemon-deckbox-stl/stl/100_deck_ver/example_images/06_build_plate_layout.png

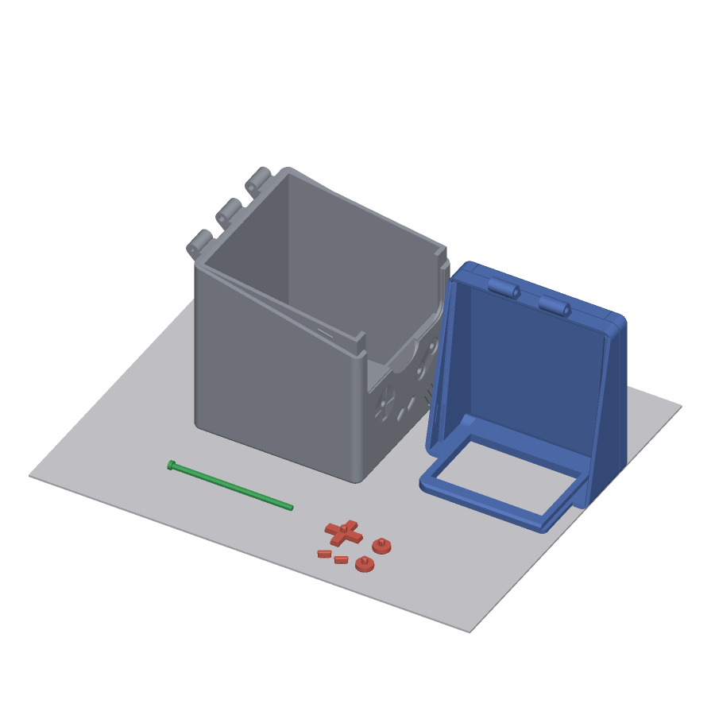
stl/100_deck_ver/example_images/06_build_plate_layout.png
