michaelwong382/pokemon-deckbox-stl/stl/100_deck_ver/example_images/07_lid_as_printed_face_down.png

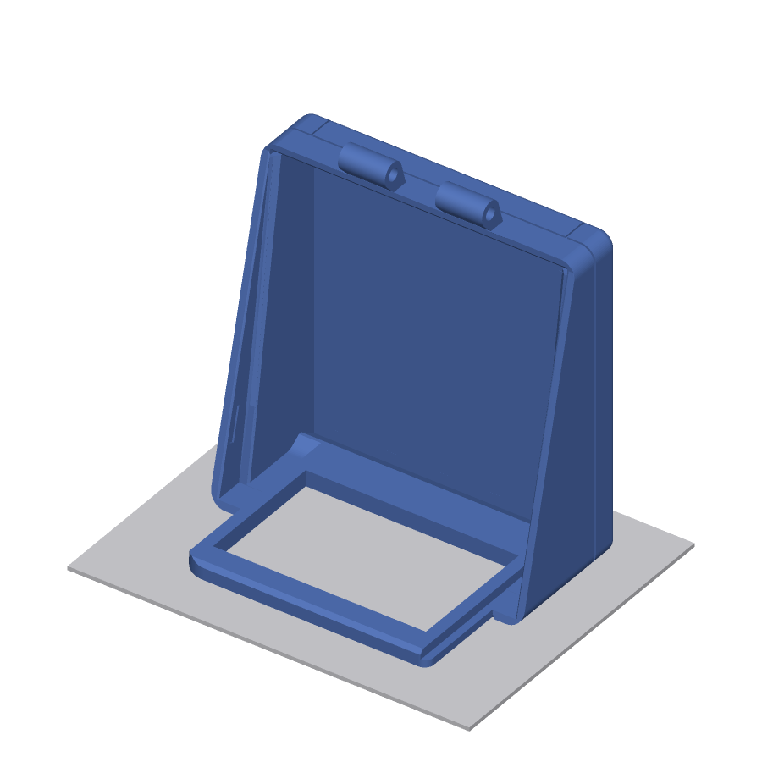
stl/100_deck_ver/example_images/07_lid_as_printed_face_down.png
