michaelwong382/pokemon-deckbox-stl/stl/100_deck_ver/example_images/08_body_as_printed_upright.png

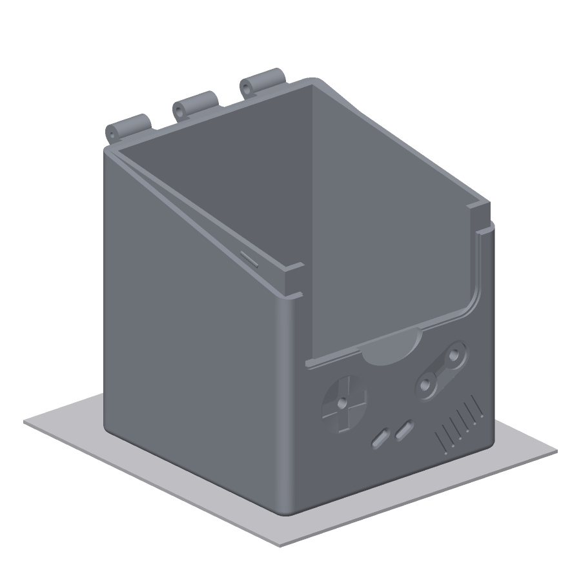
stl/100_deck_ver/example_images/08_body_as_printed_upright.png
