michaelwong382/pokemon-deckbox-stl/stl/remix/v5/example_images/19_buttons_as_printed.png

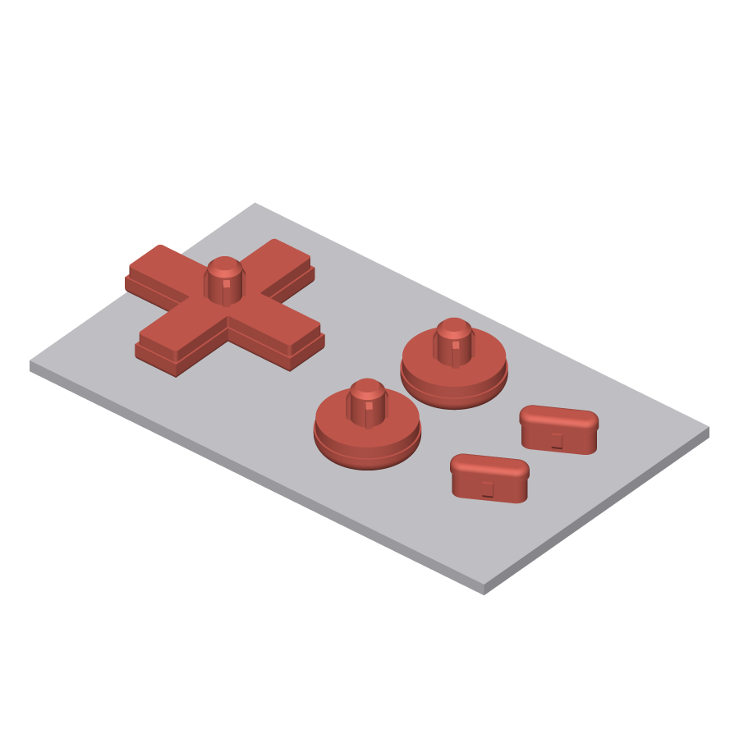
stl/remix/v5/example_images/19_buttons_as_printed.png
