michaelwong382/pokemon-deckbox-stl/stl/remix/v5/example_images/23_test_coupons_in_use.png

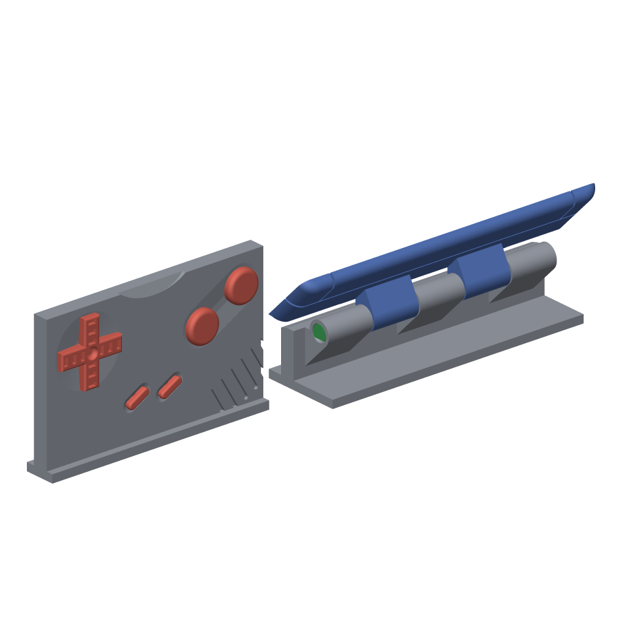
stl/remix/v5/example_images/23_test_coupons_in_use.png
