michaelwong382/pokemon-deckbox-stl/(commit log)

2026-10-29 Add Game Boy deck box remix: original files, two remix rounds, docs and renders
    - stl/original: Ashwood's STLs, 3MF and zip as downloaded
    - stl/remix: round-2 remix (96 mm interior, five-knuckle hinge with printed
    pin, support-free, 4 mm screen frame, snap catches, thumb notch, lead-in
    chamfers); stl/remix/v1 keeps round 1
    - README.md and improvements.md document every change and the mesh checks
    - images/remix: renders and before/after sections; example/: reference views
    - tools/round2_build.py reproduces the round-2 STLs from v1
2026-10-29 Move the current remix into stl/remix/v2 alongside v1
    Each remix round now has its own folder; stl/remix/README.md indexes them.
    All links, the build script's output path and the per-folder READMEs updated.
2026-10-29 Add round-3 remix: "Yoojin" engraved in the bottom instead of Ashwood's signature
    - stl/remix/v3: body with Ashwood's 1 mm signature recess filled and "Yoojin"
    engraved in script (60 x 24 mm, 1 mm deep), traced from
    images/Elegant_Yoojin_Calligraphy.png; hairlines widened to 0.6 mm and inside
    corners rounded to 0.2 mm so it prints cleanly; lid and pin copied from v2
    - tools/round3_build.py reproduces the v3 body from v2 and the image
    - stl/remix/v3/example_images: renders of v3, including three views of the bottom
    - README, improvements.md (section 10) and folder READMEs updated; v2 is kept
    with Ashwood's signature
    - New renders: images/remix/remix_bottom.png, signature_before_after.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
2026-10-29 Add round-4 remix: D-pad and buttons redrawn to push in by hand
    The designer's buttons are drawn the exact size of their seats, so printed
    ones have to be forced in (the 3MF's own note suggests a butter knife for
    Start and Select).
    - stl/remix/v4: D-Pad_remix, Button_remix (print two) and StartSelect_remix
    (print two) with 0.15 mm clearance where they enter the front wall, crush-rib
    pegs on the D-pad and A/B (2.6 mm core, four ribs to 3.1 mm in the 2.99 mm
    hole) and a rib on each side of Start/Select; the visible tops are the
    designer's shapes. Body, lid and pin copied from v3, so the buttons also fit
    the earlier bodies and the original
    - tools/round4_build.py builds the buttons f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
2026-10-29 Add round-5 remix: print-proof engraving, recessed pin head, fit-test coupons
    - stl/remix/v5: body with the "Yoojin" engraving 0.8 mm deep and its two
    1.3 mm loops filled (no first-layer island under 2.45 mm), a 4.3 mm recess
    for the pin head in the left knuckle and a 1.6 mm knock-out hole through the
    blind right one; a new 58.5 mm pin with a 4 mm round head that sits flush;
    lid, D-pad and buttons copied from v4
    - Three test coupons cut from the finished body and lid: Test-seats (front
    wall with all five button seats), Test-hinge-body and Test-hinge-lid (the
    hinge with its knuckles), so the press fits can be checked in under an hour
    of printing before the five-hour body
    - tools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
2026-10-30 Add 100-card version: the round-5 box 37 mm deeper for 100 double-sleeved cards
    stl/100_deck_ver/ holds the round-5 remix with 72 mm of inside depth instead of 35
    (70 x 72 x 96 mm inside, 78 x 80 x 100 mm outside). The front wall with its buttons and
    notch, the back wall with the hinge and pin, the snap catches 17 mm behind the front and
    the lead-in chamfers are unchanged; "Yoojin" is engraved again in the middle of the
    longer bottom. The pin, buttons and fit-test coupons are copies of round 5's.
    tools/deck100_build.py makes the files from stl/remix/v4 (body) and stl/remix/v5: every
    vertex behind a cut plane through plain wall moves back 37 mm, and the vertices on the
    two sloping side-wall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
2026-10-31 Add Pikachu versions: seven round-5 forks with a drawing engraved in the back wall
    stl/pickachu/ holds complete file sets, each round 5 with only the body
    changed (v7 also the lid): a sitting Pikachu outline (v1); the Pikachu-in-
    berries pattern cropped upright (v2) and turned 90 degrees (v3); and the
    same pattern over the whole back wall with the depth fading at the edges
    (v4), the lines dropping out (v5), or whole line segments pruned while the
    drawing stays connected (v6); v7 is v6 with a Pokeball engraved in the top
    of the lid. All engravings are 0.8 mm deep and stop below the hinge's
    support wedge at Z 76.4.
    tools/pickachu_samples.py previews each drawing painted on the back wall
    (stl/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
